LiangPI-boob/cell-metabolism-monitor/hardware/pcb/NanostatPictures.png

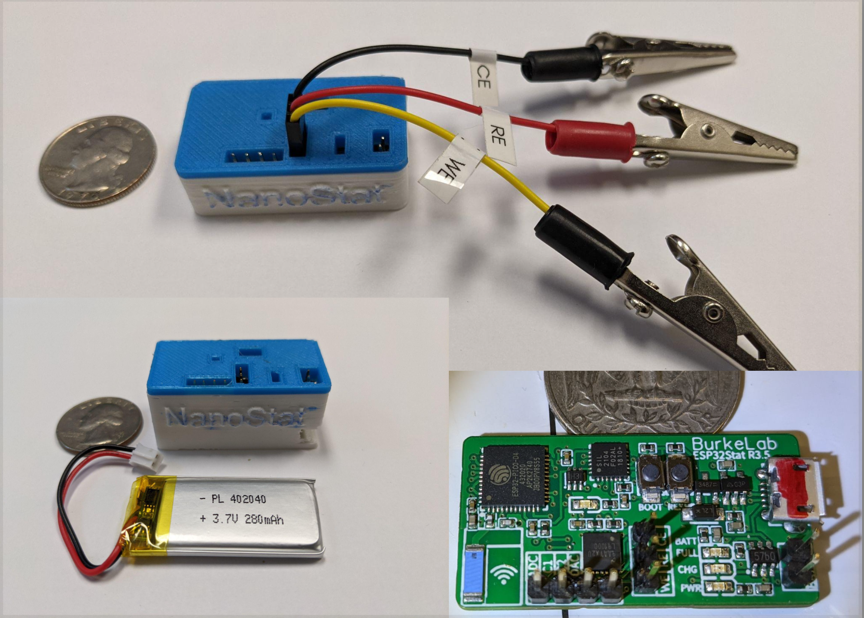
hardware/pcb/NanostatPictures.png
