LiangPI-boob/cell-metabolism-monitor/docs/协作者同步摘要.md

# 协作者同步摘要

> **用途**：让新协作者（及其 AI agent）用最短时间同步项目进度。
> **生成时间**：2026-10-27（已含第 4 轮「实时状态监控 + 泵 PWM 可调」改动）
> **建议阅读顺序**：本文件 → [`项目进度总结.md`](项目进度总结.md) → [`主从WiFi通信开发文档.md`](主从WiFi通信开发文档.md)

---

## 〇、仓库地址（重要）

| 项 | 值 |
|---|---|
| **当前协作仓库（GitHub）** | **https://github.com/LiangPI-boob/cell-metabolism-monitor**（公开） |
| 本地 remote 名 | `github`（另有一个历史 remote `origin` 指向 Gitee） |
| 协作者 | GitHub 用户 `shuhui-wang`（已发 write 权限邀请，需对方在 GitHub 接受） |

> ⚠️ **关于文档里出现的 Gitee 链接**
> `https://gitee.com/shuhui-wang/cell-metabolism-monitor` 是**协作者 shuhui-wang 此前使用的 Gitee 仓库地址**，仅作历史参考，**不是当前的同步目标**。
> 项目后续统一以 **GitHub 仓库 `LiangPI-boob/cell-metabolism-monitor`** 为准；若两处内容不一致，以 GitHub 为准。

---

## 一、给 AI agent 的同步指令（可直接复制）

> 请先读仓库根目录 `README.md`，**然后必须完整读 `docs/项目进度总结.md`**（跨会话上下文入口，含进度、代码位置行号、踩坑、卡点），再按需读 `docs/主从WiFi通信开发文档.md` 第 13 章。
> 当前状态：主机 ESP32 与从机 ESP32 已通过 Wi-Fi TCP 打通，实测 `"slave_link":"online"`。
> **唯一阻塞项是硬件电平问题——泵不转，因为 3.3V GPIO 驱动不了「5V 高电平触发」驱动模块，不要试图靠改代码解决。**
> 烧录前必须按 USB 序列号认板（`0001`=从机 COM5，`02DA3ECE`=主机 COM6）。改动前先 `git status`，凭据文件已 gitignore，不要提交。

---

## 二、项目是什么 + 系统架构

做一台**自动养细胞 + 自动测代谢指标（葡萄糖/乳酸）**的准连续监测系统：

1. 细胞在 PC 0.4μm 多孔膜上静置培养
2. 代谢物透过膜扩散进「膜下小体积腔」（约 78 μL）
3. 下腔与独立检测模块用软管闭环循环
4. 停流静测（安培法）+ 每 6 小时在线自校准
5. 覆盖 12~72 小时无人值守

```
[手机/PC 浏览器] ⇄ Wi-Fi ⇄ [主机 NanoStat：ESP32-PICO-D4 + LMP91000]
                              ├ 电化学采集（ADC/C1/C2/DAC）
                              ├ 网页 :80 + WebSocket :81
                              ├ 实验调度状态机（本机执行，不依赖 PC）
                              └ SoftAP「NanoStatAP」+ TCP Server 192.168.4.1:3333
                                        ⇅ JSON 行协议（Wi-Fi，一行一个 JSON，\n 结尾，≤512 B）
                                 [从机 ESP32 流体控制板]
                                  ├ 循环泵 → GPIO25
                                  ├ 切换阀 → GPIO26
                                  └ 排废阀 → GPIO27
```

实验状态机：`IDLE → CIRCULATE → STOP_FLOW → MEASURE →（CALIBRATE）→ CIRCULATE`

---

## 三、进度总览

| # | 阶段 | 状态 | 说明 |
|---|---|---|---|
| ① | 硬件采购 | ✅ 完成 | 全部到货 |
| ② | 开发环境 | ✅ 完成 | PlatformIO（主机）+ Arduino IDE（从机） |
| ③ | 从机固件 | ✅ 已烧录联网 | v1.2，COM5；`hello` 鉴权、心跳、断线重连实机通过 |
| ④ | 主机固件 | ✅ 已烧录最新 | COM6；APSTA + TCP Server + 调度状态机 + 链路广播 |
| ⑤ | 网页控制 | ✅ 已上传并可访问 | 4 页结构，uPlot 已本地化，无外网依赖 |
| ⑥ | 泵动作测试 | ⚠️ **根因已定位，未解决** | GPIO25 回 `ok:true` 但泵不转 → **3.3V 电平不足以触发 5V 高电平驱动模块** |
| ⑦ | 阀动作测试 | ⬜ 未做 | 两个阀均未实测动作 |
| ⑧ | 双板联调 | 🟡 链路已通 | 2026-10-25 实测 `slave_link:"online"`；T3–T8 台架测试待做 |
| ⑨ | 下腔替代件 | ⬜ 未做 | 图纸已画好（`hardware/drawings/`） |
| ⑩ | 流体管路图 | ✅ v1 完成 | `流体管路连接图_v1.svg`，含管段清单、装配顺序、3 个待确认项 |
| ⑪ | 代码共享 | ✅ 已推送 | GitHub 公开仓库（见本文第〇节） |

> **最近一次改动（2026-10-27）**：状态广播新增 `mode` / `next_action` / `next_in_ms` / `pump_pct`；停流拆为「开阀 `valve_open_s` + 关阀静置」两段；新增手动泵阀控制（会退出自动流程）；新增泵 PWM 占空比 `pump_pct`（默认 50%，1–100%）；网页新增下一动作倒计时、离线态、手动按钮与 PWM 滑块。详细清单与编译记录见 `项目进度总结.md` 4.8 节。同时已合并远端协作者提交（实验数据存档、掉线停机、浓度换算、演示模式，新增 `tools/analyze_experiment.py`）。

---

## 四、关键参数速查

| 项 | 值 |
|---|---|
| 认板方式 | 两块板都是 CP210x，**必须按序列号**：`0001` → COM5 = 从机；`02DA3ECE` → COM6 = 主机 |
| 主机板 | ESP32-PICO-D4 rev1.1，MAC `a4:f0:0f:1c:ee:34` |
| 从机板 | ESP32-D0WD-V3，MAC `ec:c9:ff:fe:c3:d0` |
| 主机引脚 | DAC 25、LED 26、LMP_C1 27、ADC 35、LMP_C2 39、MENB 5 |
| 从机引脚 | 循环泵 25、切换阀 26、排废阀 27（`GPIO1/3` 保留 USB 调试串口） |
| 板间链路 | 主机 SoftAP `NanoStatAP` + TCP Server `192.168.4.1:3333`；从机 STA 作 TCP Client |
| 心跳 | 主机每 5 s 发 `ping`；从机 120 s 无消息进安全态；主机 20 s 判离线 |
| 安全限时 | 阀最长 30 s、泵单次最长 1 h、上电默认泵停阀关 |
| 网页入口 | `http://192.168.4.1/`（连热点）或 `http://nanostat.local/`（路由模式） |
| 主机编译占用 | RAM 30.5%（100,012 B）、Flash 76.1%（997,229 B） |

---

## 五、首次上手 4 步

1. **补凭据**（不入库，缺失会 `#error`）：
   - `src/wifi_credentials.example.h` → `src/wifi_credentials.h`
   - `slave/slave_firmware/wifi_secrets.example.h` → `wifi_secrets.h`
   - `SLAVE_WIFI_PASS` 必须等于主机 `AP_PASSWORD`；`SLAVE_LINK_KEY` 两端必须一致
2. **烧主机**：

```powershell
$pio = "C:\Users\Liang\.platformio\penv\Scripts\pio.exe"
& $pio device list                                      # 先按 SN 确认 COM 口
& $pio run -e pico32 -t upload   --upload-port COM6
& $pio run -e pico32 -t uploadfs --upload-port COM6     # 仅在改了 data/ 网页时
```

3. **烧从机**：Arduino IDE 打开 `slave/slave_firmware/slave_firmware.ino`，装 ArduinoJson，选 COM5 上传
4. **验证链路（不动执行器）**：
   - `GET http://nanostat.local/netinfo` 看 `sta_connected` 与 `ap_clients`
   - 连 `ws://<主机IP>:81/` 读一帧状态，看 `"slave_link":"online"`

---

## 六、当前卡点与下一步

**卡点：泵不受 ESP32 控制（已定位为电平问题）**

| 测试 | 结果 | 结论 |
|---|---|---|
| 泵两根线直接接 5V | 泵转 | 电源、电源轨、泵正常 |
| 驱动模块 SIG 碰 5V | 泵转 | 驱动模块、接线正常 |
| GPIO25 → 模块 SIG，发 pump 命令 | 回 `ok:true`，泵不转 | **3.3V 不足以触发「5V 高电平触发」模块** |
| ESP32 GND ↔ 面包板蓝轨 | 已接 | 共地没问题 |

**下一步 6 步**

```
① 补 3.3V→5V 电平转换（BSS138 四路小板）或换 3.3V 兼容/带光耦模块 → 泵受控
     ↓
② 测两个阀（GPIO26/27，先 5V 碰听「咔哒」，再走命令）
     ↓
③ 台架 T3–T8：命令一致性 / 断线安全 / 换信道 / 24 h / EMI / 网页回归
     ↓
④ 管路干接 + 清水试漏（按《流体管路连接图_v1.svg》）
     ↓
⑤ 网页点「启动实验」，跑通 循环→停流→静测→校准（校准目前仍为占位，只计时）
     ↓
⑥ 做下腔替代件，替换烧杯接入回路
```

---

## 七、必知的坑（完整 11 条见 `项目进度总结.md` 第五节）

1. **串口日志停在 `BOOT: LMP init done` 不是崩溃** —— 是 CP210x 的 DTR/RTS 自动复位在反复拉 EN；判板子好坏看热点是否出现、LED 是否闪 15 次。
2. **`uploadfs` 会擦掉 SPIFFS 里的 `/calibration.JSON`** —— 日常不要跑；Wi-Fi 配置存在 NVS，不丢。
3. **国内网络装 ESP32 包 / PlatformIO 会卡** —— 用镜像或代理；移动工程后报错先删 `.pio`。
4. **不会误提交凭据** —— `.gitignore` 已覆盖 `src/wifi_credentials.h`、`slave/slave_firmware/wifi_secrets.h`、`data/secrets.json`、`.pio/`。

---

## 八、文件地图（按阅读优先级）

| 优先级 | 文件 | 用途 |
|---|---|---|
| 1 | `docs/项目进度总结.md` | **入口**：进度、代码行号位置、踩坑、卡点、下一步 |
| 2 | `docs/主从WiFi通信开发文档.md` | 协议、时序、改造点、13 章实机部署手册 |
| 3 | `README.md` | 目录结构、引脚、编译烧录、访问方式 |
| 4 | `docs/芯片设计说明书.md` / `docs/软件需求说明书.md` | 系统方案 / FR-1~FR-8 |
| 5 | `docs/硬件交接单.md` | 接线、共地、单件测试、安全约束 |
| — | `src/main.cpp`（主机 ~4200 行） | 固件主逻辑 |
| — | `slave/slave_firmware/slave_firmware.ino`（~350 行） | 从机固件 |
| — | `data/` | 网页（改完必须 `uploadfs`） |
| — | `.trae/specs/establish-master-gateway-wifi-link/` | 链路改造的 spec / tasks / checklist |

**主机固件关键函数位置（`src/main.cpp`）**

| 功能 | 约行号 |
|---|---|
| `setUpAPService()` | 1034 |
| `slaveSend()` / `slaveLoop()` | 4470 / 4486 |
| `expBroadcastState()` | 4640 |
| `expPumpRun()` | 4681 |
| `expStart()` | 4689 |
| `serviceExperiment()` | 4735 |

---

## 九、维护约定

- 进度变化时**优先更新 `docs/项目进度总结.md`**，再同步本文件第三节的表格与「生成时间」。
- 本文件只做「汇总与导航」，不重复设计文档的正文，避免两份内容打架。
- 仓库地址若有变更，请同步修改本文第〇节。

### 版本标记

每完成一轮需求（或一次可烧录验证的改动）在 `main` 上打一个附注标签，并在 GitHub 用该标签发布 Release：

```
git tag -a v0.4.0 -m "一句话说明本轮内容"
git push github v0.4.0
```

- 编号规则：`v0.<轮次>.0`，与 `项目进度总结.md` 的「第 N 轮需求」对齐；该轮内的修补用 `v0.4.1`。
- 标签只加不改：已推送的标签如需修正，用新的补丁号，不要强推覆盖。
- 固件要随版本分发时，`pio run -e pico32` 后把 `.pio/build/pico32/firmware.bin` 与 `spiffs.bin` 附到对应 Release，避免他人拿到与源码不一致的固件。
- 已有标签：`v0.4.0`（实时状态监控 + 泵 PWM + 协作者合并）。
