LiangPI-boob/cell-metabolism-monitor/docs/项目进度总结.md

# 细胞代谢监测系统 —— 项目进度总结

> **更新时间**：2026-10-27
> **用途**：跨对话传递上下文。**新对话 / 新 AI 会话请先读本文件**，再读配套文档。
> **配套文档**：《芯片设计说明书.md》《开发方案.md》《软件需求说明书.md》《硬件交接单.md》《主从WiFi通信开发文档.md》
> **工程根目录**：`f:\Trae\project\cell-metabolism-monitor`

---

## 一、项目是什么

**一句话**：做一台能**自动养细胞 + 自动测代谢指标（葡萄糖/乳酸）**的准连续监测系统。

**核心原理**
1. 细胞在多孔膜（PC 0.4μm）上静置培养
2. 代谢物透过膜扩散进「膜下小体积腔」（约 78 μL）
3. 下腔与独立检测模块用软管**闭环循环**
4. 停流静测（安培法）+ 每 6 小时**在线自校准**
5. 覆盖 **12~72 小时无人值守**

**系统架构（双 MCU）**

```
[手机/PC 浏览器] ⇄ Wi-Fi ⇄ [主机 NanoStat (ESP32-PICO-D4 + LMP91000)]
                              ├─ 电化学采集（ADC/C1/C2/DAC）
                              ├─ 网页 :80 + WebSocket :81
                              ├─ 实验调度状态机（本机执行，不依赖 PC）
                              └─ SoftAP「NanoStatAP」+ TCP Server :3333
                                        ⇅ JSON 行协议（Wi-Fi）
                                 [从机 ESP32 流体控制板]
                                  ├─ 循环泵 → GPIO25
                                  ├─ 切换阀 → GPIO26
                                  └─ 排废阀 → GPIO27
```

---

## 二、团队分工

| 人 | 负责 |
|---|---|
| **用户（本对话主人）** | **软件**：主机固件、从机固件、网页 |
| 同学 | 硬件：接线、机械加工、下腔替代件 |

---

## 三、整体进度总览

| 阶段 | 状态 | 说明 |
|---|---|---|
| ① 硬件采购 | ✅ 完成 | 全部到货 |
| ② 开发环境 | ✅ 完成 | Arduino IDE（从机）+ VS Code/PlatformIO（主机） |
| ③ 从机固件 | ✅ 已烧录并联网 | v1.2，COM5；`hello` 鉴权、心跳、断线重连全部实机通过 |
| ④ 主机固件 | ✅ 已烧录最新 | COM6；APSTA + TCP Server + 调度状态机 + 链路状态广播 |
| ⑤ 网页控制 | ✅ 已上传并可访问 | 4 页结构（控制台/参数/系统/帮助），uPlot 已本地化 |
| ⑥ 泵动作测试 | ⚠️ **根因已定位，未解决** | GPIO25 命令回 `ok:true` 但泵不转 → **3.3V 电平不足以触发 5V 高电平驱动模块** |
| ⑦ 阀动作测试 | ⬜ 未做 | 两个阀均未实测动作 |
| ⑧ 双板联调 | 🟡 **链路已通** | 2026-10-25 实测 `slave_link:"online"`；T3–T8 台架测试待做 |
| ⑨ 下腔替代件 | ⬜ 未做 | 图纸已画好（`hardware/drawings/`） |
| ⑩ 流体管路图 | ✅ v1 完成 | `流体管路连接图_v1.svg`，含管段清单、装配顺序、3 个待确认项 |
| ⑪ 代码共享 | ✅ 已推送 | **GitHub 公开仓库**（当前协作仓库）；Gitee 为协作者旧地址，见第八节 |

---

## 四、已完成工作的详细信息

### 4.1 硬件采购（全部到货）

| 物料 | 规格 | 数量 |
|---|---|---|
| 蠕动泵 + 驱动模块套件 | 5V，管 内径3mm×外径5mm | 2 |
| 单独驱动模块 | MOS 管型，**高电平触发**，支持 PWM | 2 |
| 电磁阀 | 0520E，**常闭(NC)**，额定 DC4.5V（工作 4.0~6.0V），320mA | 3 |
| 电源适配器 | 5V/2A | 1 |
| 锂电池 | 5V（备选供电） | 1 |
| 硅胶软管 | 内径3mm × 外径5mm | 5m |
| Y型三通 / L型弯头 | 3.2 / 3.0 | 各 10 |
| PC 膜 | 0.4 μm，90mm | 1 |
| 亚克力板 / 硅胶板 | 3mm / 1mm | 3 / 1 |
| O型圈 | 线径2.0 / 外径11mm | — |
| ESP32 开发板 | CP2102，Type-C（**从机**） | 1 |
| 面包板、杜邦线、拨插端子 | — | 若干 |

### 4.2 从机固件 ✅ 已烧录并联网

**文件**：`slave/slave_firmware/slave_firmware.ino`（v1.2，约 350 行）

**硬件配置**

| 执行器 | 引脚 | 通道号 |
|---|---|---|
| 循环泵 | GPIO25 | pump ch 0 |
| 切换阀 | GPIO26 | valve ch 0 |
| 排废阀 | GPIO27 | valve ch 1 |
| 接主机 | Wi-Fi STA → TCP Client `192.168.4.1:3333` | — |

**关键实现**
- **双通道**：USB Serial（调试）+ Wi-Fi TCP（接主机）；两个通道都能收命令，响应回到发命令的通道。`Serial2`（GPIO32/33）仅台架备用，**非运行链路**
- **驱动模块高电平触发**（已验证）：`HIGH` = 导通
- **安全保护**：心跳超时 **120 s** → 停泵关阀并上报（`g_safeLatched` 保证**只报一次**）；阀最长 **30 s**；泵单次最长 **1 h**；上电默认泵停阀关
- **断线重连**：退避 1 / 2 / 5 / 10 / 30 s；`WiFi.setSleep(false)`、`setAutoReconnect(true)`、`setNoDelay(true)`
- **半行缓冲修复**：TCP 刚断开会清空 `g_rxLineTcp`，避免重连后新旧半行拼接导致 `E_BAD_CMD`
- 非阻塞设计（全程 `millis()`）

**JSON 行协议（一行一个 JSON，`\n` 结尾，≤512 B）**

```json
{"cmd":"ping"}
{"id":1,"cmd":"pump","ch":0,"speed":50,"ms":60000}
{"id":2,"cmd":"valve","ch":0,"state":"open"}
{"id":3,"cmd":"stop_all"}
{"id":4,"cmd":"status"}
{"id":5,"cmd":"clear"}
```

响应 `{"id":1,"ok":true}` / `{"id":2,"ok":false,"err":"E_PARAM","msg":"..."}`；事件 `{"evt":"boot",...}`、`{"evt":"hb","state":"IDLE","uptime_ms":...}`、`{"evt":"fault","code":"E_NO_HEARTBEAT"}`、`{"evt":"hello","fw":"slave-1.2","key":"...","channels":{"pump":1,"valve":2}}`

**验证结果**：USB 串口正常输出 `boot` 与 5 s 一次 `hb`；已连上主机 AP 并通过 `hello` 鉴权，主机侧显示在线。

### 4.3 主机固件 ✅ 已烧录最新

**工程**：`platformio.ini` + `src/main.cpp`（约 4200 行，`[env:pico32]`）
**编译**：RAM 30.5%（100,012 B）、Flash 76.1%（997,229 B）（2026-10-27 合并远端后重新编译）

**板间链路模块（`src/main.cpp`）**

| 功能 | 位置 |
|---|---|
| `setUpAPService()`：`WIFI_AP_STA` + SoftAP `NanoStatAP` + `g_slaveServer.begin()` | 约 1034 |
| `slaveSend()` / `slaveLoop()`：接入、单客户端限制、按行解析、`hello` 鉴权、5 s `ping`、20 s 判离线 | 4470 / 4486 |
| `expBroadcastState()`：状态广播，含 `"slave_link":"online"/"offline"` | 4640 |
| `expPumpRun()`：泵 `ms = circulate_ms + 60000`（有限时长，不再常开） | 4681 |
| `expStart()`：从机离线时拒绝启动并广播 `{"exp_error":"slave_offline"}` | 4689 |
| `serviceExperiment()`：`IDLE → CIRCULATE → STOP_FLOW → MEASURE → (CALIBRATE) → CIRCULATE` | 4735 |
| `setup()`：启动顺序与 `BOOT:` 日志 | 约 4200 |

**关键行为**
- AP **常开**，STA 失败也不关 AP；STA 成功时 AP 跟随路由器信道
- 心跳在 IDLE 阶段也发（否则从机 120 s 后误判失联）
- 实验参数可在线改：`change_exp_circulate_min` / `stop_flow_min` / `calib_interval_h` / `calib_min`
- 校准阶段目前仍是**占位**（只计时，未接切阀/标准液）

**主机引脚**：`DAC=25`、`LED=26`、`LMP_C1=27`、`ADC=35`、`LMP_C2=39`、`MENB=5`
→ 与从机引脚重复是正常的，两块独立板。

### 4.4 网页 ✅ 已上传 SPIFFS

**目录**：`data/`

| 文件 | 作用 |
|---|---|
| `index.html` | 控制台：实验流程 / 手动扫描 / 实时曲线 |
| `setup.html` | 扫描参数（按模式折叠） |
| `system.html` | 系统：文件、Wi-Fi、固件、重启 |
| `help.html` | 帮助与关于（含「网络与访问方式」） |
| `assets/app.css` | 全站样式 |
| `assets/app.js` | 工具函数 + **全站唯一 WebSocket** + 网络提示条（读 `/netinfo`） |
| `assets/console.js` | 控制台逻辑 |
| `assets/system.js` | 系统页逻辑 |
| `assets/uplot.min.js/.css` | **本地图表库**，已不再引用外网 CDN |

**访问**：`http://nanostat.local/`（STA 已连路由器/热点时）或 `http://192.168.4.1/`（连 `NanoStatAP` 时）
**改网页后必须重新 `uploadfs`。**

### 4.5 板间链路实测结果（2026-10-25）

| 检查项 | 结果 |
|---|---|
| 主机 `/netinfo` | `{"ap_ssid":"NanoStatAP","ap_ip":"192.168.4.1","ap_clients":1,"sta_connected":true,"sta_ssid":"OnePlus Ace 5 Pro 5B70","sta_ip":"10.19.243.225","sta_rssi":-52}` |
| 主机 WebSocket 状态 | `{"exp_state":"IDLE","exp_cycle":0,"calib_in_ms":0,"pump_on":false,"valve0":false,"valve1":false,"circulate_min":5,"stopflow_min":5,"calib_interval_h":6,"calib_min":3,"slave_link":"online"}` |
| 从机串口 | `{"evt":"boot","fw":"slave-1.2",...}` + 5 s 一次 `{"evt":"hb","state":"IDLE",...}` |
| 结论 | **AP 接入、TCP 连接、`hello` 鉴权、心跳、状态广播全链路通过** |

### 4.6 项目文档

| 分类 | 文件 | 内容 |
|---|---|---|
| 方案 | `docs/芯片设计说明书.md` | 系统方案、芯片/检测模块参数、测量协议 |
| 方案 | `docs/开发方案.md` | 从机详细设计（硬件/固件/协议/测试/采购） |
| 方案 | `docs/软件需求说明书.md` | 软件需求，第四章＝对硬件的接口要求 |
| 方案 | `docs/实验创新性分析报告.md` | 系统级创新点论证 |
| 方案 | `docs/网页优化方案.md` | 网页结构、风格统一与格式规范 |
| 开发 | `docs/主从WiFi通信开发文档.md` | **主机↔从机 Wi-Fi TCP 链路：协议、改造点、测试计划、实施记录** |
| 硬件 | `docs/硬件交接单.md` | GPIO 分配、接线规范、单件测试、安全约束 |
| 硬件 | `hardware/drawings/` | 下腔替代件加工图、流体管路连接图、芯片设计图 |
| 进度 | `docs/项目进度总结.md` | 本文件 |
| 协作 | `docs/协作者同步摘要.md` | 给协作者及其 AI agent 的同步摘要（含仓库地址说明） |
| 汇报 | `docs/PPT大纲.md` | 汇报提纲 |
| 规格 | `.trae/specs/establish-master-gateway-wifi-link/` | `spec.md` / `tasks.md` / `checklist.md` |

### 4.7 开发环境与烧录

| 项 | 配置 |
|---|---|
| 工程根目录 | `f:\Trae\project\cell-metabolism-monitor` |
| PlatformIO | `C:\Users\Liang\.platformio`（`pio.exe` 在 `penv\Scripts\`） |
| 主机板 | ESP32-PICO-D4 rev1.1，MAC `a4:f0:0f:1c:ee:34`，CP210x **SN `02DA3ECE` → COM6** |
| 从机板 | ESP32-D0WD-V3，MAC `ec:c9:ff:fe:c3:d0`，CP210x **SN `0001` → COM5** |
| 从机编译 | 用**临时 PlatformIO 工程**（把 `.ino` 放进 `src/`，`board = esp32dev`，`ArduinoJson@^7`），或 Arduino IDE 选 ESP32 Dev Module |

**主机**

```powershell
$pio = "C:\Users\Liang\.platformio\penv\Scripts\pio.exe"
& $pio device list                    # 先确认 COM 口（按 SN 区分两块板）
& $pio run -e pico32 -t upload  --upload-port COM6
& $pio run -e pico32 -t uploadfs --upload-port COM6
```

**从机**：Arduino IDE 打开 `slave/slave_firmware/slave_firmware.ino` → 选 COM5 → 上传。

**凭据（均不入库，`.gitignore` 已覆盖）**

| 文件 | 内容 | 备注 |
|---|---|---|
| `src/wifi_credentials.h` | `SSID`/`PASSWORD`（占位）、`AP_PASSWORD`、`SLAVE_LINK_KEY` | `SSID/PASSWORD` 目前**不参与连接**，路由器凭据由网页保存 |
| `slave/slave_firmware/wifi_secrets.h` | `SLAVE_WIFI_SSID`=NanoStatAP、`SLAVE_WIFI_PASS`=**必须等于** `AP_PASSWORD`、`SLAVE_LINK_KEY`=**必须与主机一致** | 缺失时编译直接 `#error` |

> Wi-Fi STA 凭据实际保存在 **NVS**（`connectAttempt("","")` 读 NVS），所以 `uploadfs` 不会丢 Wi-Fi 配置；
> 但 `/calibration.JSON` 在 **SPIFFS** 里，`uploadfs` 会擦掉，重烧前如需保留请先备份。

---

### 4.8 2026-10-27 改动（第 4 轮需求：实时状态监控 + 泵 PWM 可调）

**代码改动**：4 个文件，+395 / −22（`src/main.cpp`、`data/index.html`、`data/assets/console.js`、`data/assets/app.css`）

**主机固件 `src/main.cpp`**

- 状态广播新增 `mode`（auto / manual / idle）、`next_action`、`next_in_ms`、`pump_pct`：告知前端下次要启动哪个泵或阀、还剩多久、当前模式
- **停流阶段拆成两个子阶段**：先开阀 `valve_open_s`（默认 10 s，可调 1–30 s），再关阀静置；倒计时按子阶段计算
- 新增 `g_expMeasuring`：静测采集前先广播 `measuring`，避免倒计时停在 `00:00` 让人误以为卡死
- `expPumpRun()` 补上 `g_slavePumpOn = true`，修复静测结束后重启泵时页面状态不刷新
- IDLE 空闲态也保持每 5 s 一次 `status` 轮询（其余状态 1 s），泵/阀状态不再滞留旧值
- 新增手动命令 `manual_pump` / `manual_valve0` / `manual_valve1`：任一动作先 `stop_all` 并退出自动流程，必须重新点「启动实验」才恢复
- 新增参数命令 `change_exp_circulate_min` / `change_exp_stopflow_min` / `change_exp_valve_s` / `change_exp_calib_interval_h` / `change_exp_calib_min`
- **泵 PWM**：新增 `exp_param_pump_pct`（默认 50%，范围 1–100%）与 `change_exp_pump_pct`；自动循环、校准、手动开泵统一使用；运行中调整按当前阶段剩余时长重发 `pump` 命令，立即生效且不改变剩余运行时间

**网页 `data/`**

- 「下一动作」行：动作名 + 剩余时间，前端每 250 ms 本地走秒，1 s 广播纠正
- 泵、切换阀、排废阀三行支持离线态（虚线红框 + 「离线」）；从机断开时倒计时改显示「从机离线」
- 手动按钮 6 个，按目标状态互斥禁用，离线全禁用
- 「实验参数」卡新增阀门开启时长输入（1–30 s），其余周期参数与固件值双向同步
- 「实验流程」卡新增 PWM 滑块 + 百分比读数；`pendingPct` 机制避免旧广播把滑块回弹

**编译与烧录（2026-10-27）**

| 设备 | 端口 | 结果 |
|---|---|---|
| 主机 | COM6 | 文件系统 1,441,792 B + 固件 997,616 B，Hash 校验通过；RAM 30.5% / Flash 75.6% |
| 从机 | COM5 | 固件 751,856 B，Hash 校验通过；RAM 13.7% / Flash 56.9% |

- 从机用 `%TEMP%\pio_slave` 临时 PlatformIO 工程编译（复用本机 ArduinoJson 7.4.3），**未改动仓库中的从机源码**
- 从机首次以 460800 波特率烧录在 30% 处中断，降到 115200 后成功
- 主机启动日志正常：AP+STA 双模、`[SLAVE] client connected from 192.168.4.2`

**待办（网页实测）**：倒计时平滑性、手动退出自动、离线三路同显、阀门时长生效、PWM 滑块实时生效

**同步远端**：远端已有协作者提交 `58e0804`（实验数据存档、掉线停机、浓度换算、演示模式 + `tools/analyze_experiment.py`）。已合并，冲突仅 `src/main.cpp` 5 处，按「两侧功能并存」解决：参数命令并存；`expStart` 兼顾会话初始化与手动/停流/静测复位；`expStop` 保留故障复位与 STOP 日志；`serviceExperiment` 中 IDLE 仍每 5 s 轮询 `status`，故障/掉线判定只在非 IDLE 生效；静测完成保留 measuring 复位与浓度换算/记录。合并后重新编译通过（RAM 30.5% / Flash 76.1%），**尚未重新烧录与实测**。

---

## 五、踩过的坑 & 解决方案（**重要，别重复踩**）

| # | 现象 | 原因 | 解决 |
|---|---|---|---|
| 1 | 串口日志反复停在 `BOOT: LMP init done`、看着像启动崩溃/重启循环 | **CP210x 自动复位电路（DTR=GPIO0，RTS=EN）**：每次打开串口都会拉低 EN 复位；监控工具反复开关端口就会刷出一串 `rst:0x1 (POWERON_RESET)` | 这是**假象**。一次打开端口、持续监听即可看到完整启动日志；判板子好坏请看热点是否出现、LED 是否闪 15 次 |
| 2 | `netsh wlan show networks` 看不到 `NanoStatAP` | 无线网卡当前连着别的 SSID 时，扫描结果不全/滞后 | 用手机看热点，或先把电脑切到别的网络再扫；**不能据此判定 AP 没起来** |
| 3 | `uploadfs` 后校准系数丢失 | SPIFFS 被整块擦除（`0x290000`，1.44 MB） | 重烧前先 `GET /calibration.JSON` 备份，放进 `data/` 一起烧上去，烧完再删本地副本 |
| 4 | 从机编译报 `#error 缺少 wifi_secrets.h` | 凭据文件不入库，clone/清理后会缺 | 从 `.example.h` 复制并填真实值；`SLAVE_WIFI_PASS` = 主机 `AP_PASSWORD`，`SLAVE_LINK_KEY` 两端一致 |
| 5 | 两块板都是 CP210x，容易烧错 | 同型号、端口号会变 | **按序列号区分**：`0001`=从机、`02DA3ECE`=主机；烧前先 `pio device list` |
| 6 | 主机插上电脑但设备管理器没有 CP210x | 线只供电不传数据 / 口不通 / 接头没插到位 | 换数据线、换机箱后面板 USB 口；插上应有系统提示音 |
| 7 | 网页图表空白 | 早期版本引用 `cdn.plot.ly`，热点模式无外网 | 已改为**本地 uPlot**；若仍空白，检查是否漏了 `uploadfs` |
| 8 | 从机心跳超时后串口刷屏 `E_NO_HEARTBEAT` | 原逻辑每圈 `loop()` 都触发一次 | 已用 `g_safeLatched` 修复：一次超时只报一次，收到新命令后解锁 |
| 9 | ESP32 开发板包装不上，GitHub 超时 | 国内访问 GitHub | Arduino IDE 加 jihulab 镜像，且选带 `-cn` 的版本 |
| 10 | PlatformIO 卡 `Downloading 0%` | 同上 | 用手机热点或开代理；或把 `platform` 指向本地 `~/.platformio/platforms/espressif32`，跳过在线安装 |
| 11 | 移动/改名工程后编译报错 | `.pio` 缓存记录旧路径 | 删 `.pio` 重新编译 |

---

## 六、当前卡点：泵不受 ESP32 控制（已定位为电平问题）

| 测试 | 结果 | 结论 |
|---|---|---|
| 泵两根线直接接 5V | 泵转 | 电源、面包板电源轨、泵正常 |
| 驱动模块 SIG 用杜邦线碰 5V | 泵转 | 驱动模块、接线正常 |
| ESP32 GPIO25 → 模块 SIG，发 pump 命令 | 串口回 `ok:true`，泵不转 | **3.3V 输出不足以触发「5V 高电平触发」模块** |
| ESP32 GND ↔ 面包板蓝轨 | 已接 | 共地没问题 |

**结论**：软件/协议没问题，问题在 **3.3V → 5V 电平**。
**解决**：买 3.3V→5V 电平转换模块（BSS138 四路小板）或换 3.3V 兼容/带光耦的驱动模块。

---

## 七、下一步计划

```
① 补 3.3V→5V 电平转换 → 泵受控（GPIO25）
     ↓
② 测两个阀（GPIO26/27，5V 碰听「咔哒」，再走命令）
     ↓
③ 台架 T3–T8：命令一致性 / 断线安全 / 换信道 / 24 h / EMI / 网页回归
     ↓
④ 管路干接 + 清水试漏（按《流体管路连接图_v1.svg》）
     ↓
⑤ 网页点「启动实验」，跑通 循环→停流→静测→校准
     ↓
⑥ 做下腔替代件，替换烧杯接入回路
```

---

## 八、文件路径速查

| 内容 | 路径 |
|---|---|
| 工程根目录 | `f:\Trae\project\cell-metabolism-monitor` |
| 主机固件 | `src/main.cpp` |
| 主机凭据 | `src/wifi_credentials.h`（不入库） |
| 网页文件 | `data/`（改完要 `uploadfs`） |
| 从机固件 | `slave/slave_firmware/slave_firmware.ino` |
| 从机凭据 | `slave/slave_firmware/wifi_secrets.h`（不入库） |
| 设计文档 | `docs/` |
| 规格/任务/清单 | `.trae/specs/establish-master-gateway-wifi-link/` |
| 硬件资产 | `hardware/pcb`、`hardware/case`、`hardware/drawings` |
| PlatformIO 核心 | `C:\Users\Liang\.platformio` |
| **GitHub 仓库（当前协作仓库）** | **`https://github.com/LiangPI-boob/cell-metabolism-monitor`**（公开，remote 名 `github`） |
| Gitee 仓库（协作者旧地址，仅历史参考） | `https://gitee.com/shuhui-wang/cell-metabolism-monitor`（remote 名 `origin`，非当前同步目标） |
| 版本标签 | `v0.4.0`（第 4 轮：实时状态监控 + 泵 PWM + 协作者合并）；约定见 `docs/协作者同步摘要.md` 第九节 |

---

## 九、给下一个对话 / 下一个 AI 会话的提示

1. **先读本文件，再读 `docs/主从WiFi通信开发文档.md`**，后者有完整协议、时序参数和各改造点代码位置。
2. 用户是软件负责人，**编程基础不深**：解释要通俗，给「点哪里 / 敲什么命令」的级别，避免堆术语。
3. **两块独立的 ESP32 板**，引脚重复正常；板间链路走 Wi-Fi，**不占任何 GPIO**（UART 方案因主机 PCB 无排针已废弃）。
4. **烧录前必须按序列号认板**：COM5=`0001`=从机，COM6=`02DA3ECE`=主机。端口号会变，序列号不会。
5. **不要把"串口日志停在 LMP init"当成崩溃**：那是 CP210x 自动复位在反复拉 EN。判定板子是否正常，看热点 `NanoStatAP` 是否出现、LED 是否闪 15 次。
6. 验证链路最快的办法（不改代码、不动执行器）：
   - `GET http://nanostat.local/netinfo` 看 `sta_connected` 与 `ap_clients`
   - 连 `ws://<主机IP>:81/` 读一帧状态，看 `"slave_link":"online"`
7. **不要用 `uploadfs` 当日常操作**：会擦掉 SPIFFS 里的 `/calibration.JSON`；只改网页时才需要。
8. 当前最紧急的硬件问题是 **3.3V→5V 电平**，不是软件；不要试图用改代码解决泵不转。
9. 改动前先确认 `git status`，凭据文件（`wifi_credentials.h`、`wifi_secrets.h`）已加入 `.gitignore`，**不要提交**。
