LiangPI-boob/cell-metabolism-monitor/hardware/pcb/Version3dot5dot0/BOM_1-PCB_ESP32StatRev3_5PCB_2022-08-24.csv

ID | Name | Designator | Footprint | Quantity | Manufacturer Part | Manufacturer | Supplier | Supplier Part | Price | Pins | 3DModel
1 | LMP91000SD/NOPB | U4 | WSON-14_L4.0-W4.0-P0.50-BL-EP | 1 |  |  |  |  |  | 15
2 | U254-051T-4BH23-S2B | USB1 | MINI-USB-SMD_U254-051T-4BH23-S2B | 1 |  |  |  |  |  | 9
3 | RST | RESET | SW-SMD_L3.9-W3.0-P4.45 | 1 |  |  |  |  |  | 2
4 | 22K | R11 | R0402 | 1 |  |  |  |  |  | 2
5 | 47K | R13 | R0402 | 1 |  |  |  |  |  | 2
6 | TP4057 | U7 | SOT-23-6_L2.9-W1.6-P0.95-LS2.8-BR | 1 |  |  |  |  |  | 6
7 | 2.15K | R7,R9 | R0402 | 2 |  |  |  |  |  | 2
8 | 1K | R1 | R0402 | 1 |  |  |  |  |  | 2
9 | TS-1088R-02026 | BOOT | SW-SMD_L3.9-W3.0-P4.45 | 1 |  |  |  |  |  | 2
10 | 19-213/Y2C-CQ2R2L/3T(CY) | CHG | LED0603-R-RD | 1 |  |  |  |  |  | 2
11 | 10K | R2,R3,R4,R12 | R0402 | 4 |  |  |  |  |  | 2
12 | CP2104-F03-GM | U3 | QFN-24_L4.0-W4.0-P0.50-BL-EP2.8 | 1 |  |  |  |  |  | 25
13 | 330 | R8,R5 | R0402 | 2 |  |  |  |  |  | 2
14 | 19-217/GHC-YR1S2/3T | FULL | LED0603-R-RD | 1 |  |  |  |  |  | 2
15 | 19-217/BHC-ZL1M2RY/3T | LED2 | LED0603-R-RD | 1 |  |  |  |  |  | 2
16 | 10uF | C1,C2,C11,C3,C12 | C0402 | 5 |  |  |  |  |  | 2
17 | HDR-M-2.54_1x2 | VBAT/GND | HDR-M-2.54_1X2 | 1 |  |  |  |  |  | 2
18 | PWR | PWR | LED0603-R-RD | 1 |  |  |  |  |  | 2
19 | MBR120LSF | D5 | SOD-123_L2.8-W1.8-LS3.7-RD | 1 |  |  |  |  |  | 2
20 | UMH3NTN | Q3 | SOT-363_L2.0-W1.3-P0.65-LS2.1-TL | 1 |  |  |  |  |  | 6
21 | AP2112K-3.3TRG1 | U6 | SOT-25-5_L3.0-W1.8-P0.95-LS3.0-BR | 1 |  |  |  |  |  | 5
22 | 100nF | C4,C6,C7,C9 | C0402 | 4 |  |  |  |  |  | 2
23 | HDR-M-2.54_1x3 | WE/RE/CE | HDR-M-2.54_1X3 | 1 |  |  |  |  |  | 3
24 | 1.2pF | C10 | C0402 | 1 |  |  |  |  |  | 2
25 | 5.1nH | L2 | L0402 | 1 |  |  |  |  |  | 2
26 | KH-5220-A56 | L1 | ANT-SMD_L5.2-W2.0 | 1 |  |  |  |  |  | 2
27 | ESP32-PICO-D4 | U1 | QFN-48_L7.0-W7.0-P0.50-TL-EP5.1 | 1 |  |  |  |  |  | 49
28 | HDR-M-2.54_1x4 | J3 | HDR-M-2.54_1X4 | 1 |  |  |  |  |  | 4
29 | 100nF | C5 | C0402 | 1 |  |  |  |  |  | 2 | C0402_L1.0-W0.5-H0.5
30 | LPSC3487 | Q4 | SOT-23_L2.9-W1.3-P0.95-LS2.4-BR | 1 |  |  |  |  |  | 3
