LiangPI-boob/cell-metabolism-monitor/hardware/pcb/Version3dot5dot4/BOM_ESP32StatRev3_5_4_2024-11-27.csv

ID | Name | Designator | Footprint | Quantity | Manufacturer Part | Manufacturer | Supplier | Supplier Part | Price
1 | Header-Male-2.54_1x3 | WE/RE/CE | HDR-TH_3P-P2.54-V-M-1 | 1 | 2.54-1*3P针 | BOOMELE(博穆精密) | LCSC | C49257 | 0.014
2 | 1.5pF | C10 | C0402 | 1 | GRM1555C1H1R5BA01D | muRata(村田) | LCSC | C76957 | 0.004
3 | KPT-1608ZGC | BLNK,CHARGE,FULL,PWR | LED0603-RD_GREEN | 4 | KPT-1608ZGC | Kingbright | LCSC | C598364 | 0.293
4 | PZ254V-11-02P | VBAT/GND | HDR-TH_2P-P2.54-V-M | 1 | PZ254V-11-02P | XFCN(兴飞) | LCSC | C492401 | 0.012
5 | SI2333 | Q5 | SOT-23_L2.9-W1.3-P1.90-LS2.4-BR | 1 | SI2333 | BORN(伯恩半导体) | LCSC | C344008 | 0.05
6 | KH5220-A36 | L4 | ANT-SMD_L5.2-W2.1 | 1 | KH5220-A36 | kinghelm(金航标) | LCSC | C484543 | 0.199
7 | 4.3nH | L5 | L0402 | 1 | SDCL1005C4N3STDF | Sunlord(顺络) | LCSC | C52051 | 0.003
8 | TP4057 | U7 | SOT-23-6_L2.9-W1.6-P0.95-LS2.8-BR | 1 | TP4057 | TOPPOWER | LCSC | C12044 | 0.122
9 | RT9078-33GJ5 | U5 | TSOT-23-5_L2.9-W1.6-P0.95-LS2.8-BR | 1 | RT9078-33GJ5 | Richtek Tech | LCSC | C110427 | 0.079
10 | UMH3NTN | Q3 | SOT-363_L2.0-W1.3-P0.65-LS2.1-TL | 1 | UMH3NTN | ROHM | LCSC | C123008 | 0.055
11 | U254-051T-4BH83-F1B | USB2 | MINI-USB-SMD_U254-051T-4BH83-F1B | 1 | U254-051T-4BH83-F1B | XKB Enterprise | LCSC | C319162 | 0.064
12 | CP2104-F03-GM | U3 | QFN-24_L4.0-W4.0-P0.50-BL-EP2.7 | 1 | CP2104-F03-GM | SILICON LABS | LCSC | C47742 | 2.105
13 | LMP91000SD/NOPB | U4 | WSON-14_L4.0-W4.0-P0.50-BL-EP | 1 | LMP91000SD/NOPB | TI | LCSC | C84366 | 3.22
14 | RST | RESET | SW-SMD_L3.9-W3.0-P4.45 | 1 | TS-1088R-02026 | XUNPU | LCSC | C455280 | 0.044
15 | 22K | R11 | R0402 | 1 | 0402WGF2202TCE | UniOhm | LCSC | C25768 | 0.001
16 | 47K | R13 | R0402 | 1 | 0402WGF4702TCE | UniOhm | LCSC | C25792 | 0.001
17 | 2.15K | R7 | R0402 | 1 | 0402WGF2151TCE | UniOhm | LCSC | C25878
18 | 1K | R1 | R0402 | 1 | 0402WGF1001TCE | UniOhm | LCSC | C11702 | 0.001
19 | TS-1088R-02026 | BOOT | SW-SMD_L3.9-W3.0-P4.45 | 1 | TS-1088R-02026 | XUNPU | LCSC | C455280 | 0.044
20 | 10K | R2,R3,R4,R12 | R0402 | 4 | 0402WGF1002TCE | UniOhm | LCSC | C25744 | 0.001
21 | 330 | R8,R5 | R0402 | 2 | 0402WGF3300TCE | UniOhm | LCSC | C25104 | 0.001
22 | 10uF | C1,C2,C11,C3,C12 | C0402 | 5 | CL05A106MQ5NUNC | SAMSUNG | LCSC | C15525 | 0.004
23 | MBR120LSF | D5 | SOD-123_L2.8-W1.8-LS3.7-RD | 1 | MBR120LSF | SK | LCSC | C130880 | 0.035
24 | 100nF | C4,C5,C6,C7,C9 | C0402 | 5 | CL05B104KO5NNNC | SAMSUNG | LCSC | C1525 | 0.001
25 | ESP32-PICO-D4 | U1 | QFN-48_L7.0-W7.0-P0.50-TL-EP5.1 | 1 | ESP32-PICO-D4 | Espressif Systems | LCSC | C193707 | 4.72
26 | HDR-M-2.54_1x4 | J3 | HDR-M-2.54_1X4 | 1 |  |  | LCSC | C124378 | 0.037
