LiangPI-boob/cell-metabolism-monitor/hardware/case/nobattery/Lid.stl

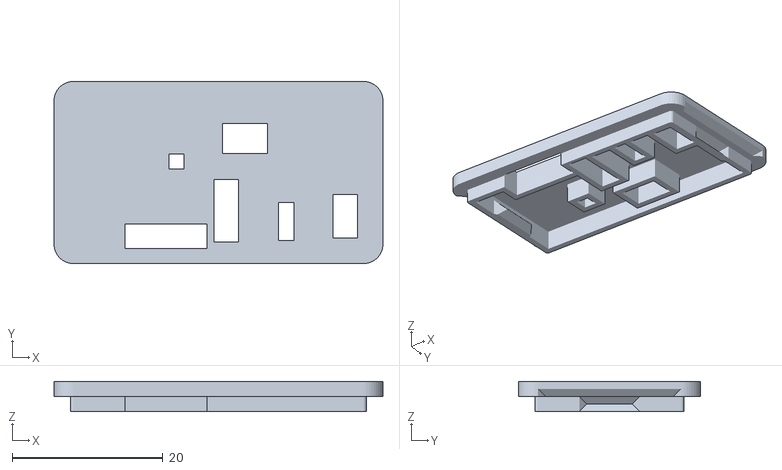
[picture p7: CAD file, 2026-10-18]
hardware/case/nobattery/Lid.stl
43.7 x 24.2 x 4.00
