LiangPI-boob/cell-metabolism-monitor/hardware/case/withbattery/Lid.stl

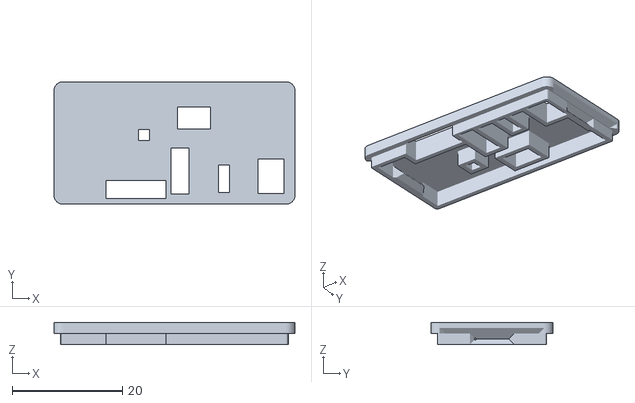
[picture p8: CAD file, 2026-10-18]
hardware/case/withbattery/Lid.stl
43.7 x 22.2 x 4.00
