LiangPI-boob/cell-metabolism-monitor/hardware/case/nobattery/Case.stl

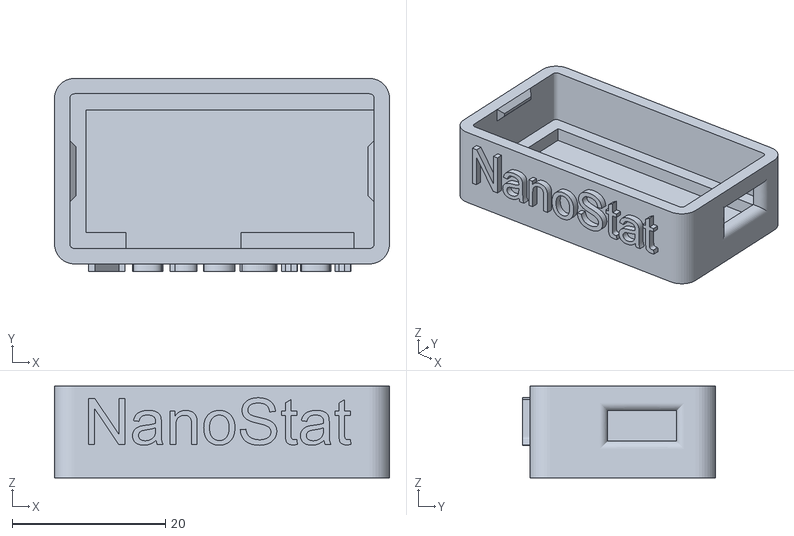
[picture p9: CAD file, 2026-10-18]
hardware/case/nobattery/Case.stl
43.7 x 25.2 x 12.0
