LiangPI-boob/cell-metabolism-monitor/hardware/case/withbattery/Case.stl

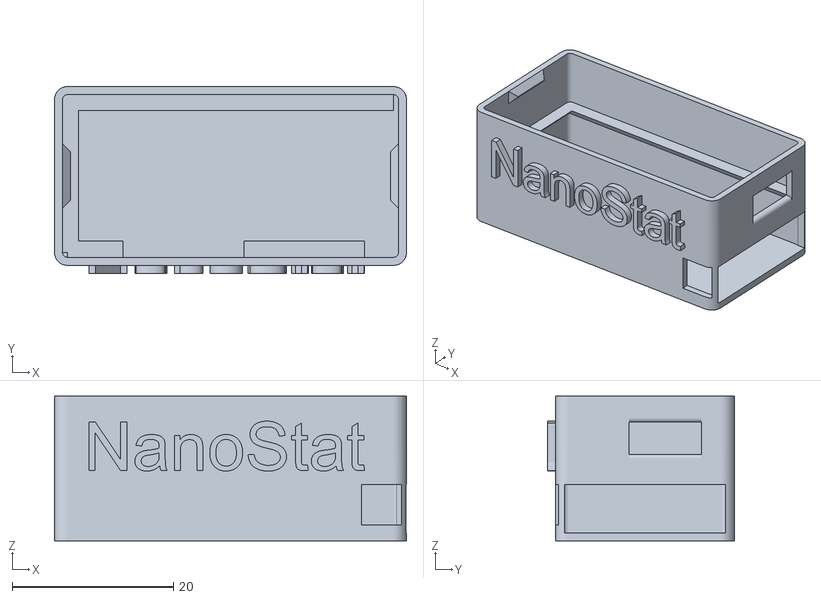
[picture p10: CAD file, 2026-10-18]
hardware/case/withbattery/Case.stl
43.7 x 23.2 x 18.0
