LiangPI-boob/cell-metabolism-monitor/(list of files, cad)

Other CAD files:
hardware/case/nobattery/NanoStatCaseNoLipoFinal v2.f3d
hardware/case/withbattery/NanoStatCaseWithLipo v147.f3d
