LiangPI-boob/cell-metabolism-monitor/hardware/pcb/Version3dot5dot0/Gerber_1-PCB_ESP32StatRev3_5PCB/How-to-order-PCB.txt

How to Order PCB

Please refer to:
https://docs.easyeda.com/en/PCB/Order-PCB
