LiangPI-boob/cell-metabolism-monitor/(list of files, drawings)

Other design files:
hardware/pcb/Version3dot5dot4/PCB_1-PCB_ESP32StatRev3_5_4_2024-11-27.json
hardware/pcb/Version3dot5dot4/SCH_ESP32StatRev3_5_4_2024-11-27.json
