LiangPI-boob/cell-metabolism-monitor/src/main.cpp

//https://github.com/PeterJBurke/Nanostat

bool userpause = false;             // pauses for user to press input on serial between each point in sweep
bool print_output_to_serial = true; // prints verbose output to serial

//Libraries
#include <Wire.h>
#include <WiFi.h>
#include "Arduino.h"
#include <ESPAsyncWebServer.h>
#include <ESPmDNS.h>
#include <SPIFFS.h>
#include <time.h>
#include <AsyncJson.h>
// 凭据来自不入库的 wifi_credentials.h（由 wifi_credentials.example.h 复制）。
#if __has_include("wifi_credentials.h")
#include "wifi_credentials.h"
#else
#error "缺少 wifi_credentials.h：请复制 src/wifi_credentials.example.h 为 src/wifi_credentials.h 并填写"
#endif

#ifndef AP_PASSWORD
#error "缺少 AP_PASSWORD：请在 src/wifi_credentials.h 中定义（至少 8 位）"
#endif
#ifndef SLAVE_LINK_KEY
#error "缺少 SLAVE_LINK_KEY：请在 src/wifi_credentials.h 中定义（须与从机 wifi_secrets.h 一致）"
#endif

#include "LMP91000.h"
#include "WebSocketsServer.h"
#include "DNSServer.h"
// #include <OTA.h>
#include <Update.h>
#include "soc/soc.h"
#include "soc/rtc_cntl_reg.h"



// Microcontroller specific info (pinouts, Vcc, etc)
const uint16_t opVolt = 3300;                 //3300 mV
const uint8_t adcBits = 12;                   // ESP32 ADC is 12 bits
const uint16_t dacResolution = pow(2, 8) - 1; // ESP32 DAC is 8 bits, that is 12.9 mV for 3300 mV reference...
//LMP91000 control pins
const uint8_t dac = 25; // DAC pin for Vref to drive LMP91000. Pin 25 on BurkeLab ESP32Stat Rev 3.5
const uint8_t MENB = 5; // LMP91000 enable pin. Hard wired to ground in BurkeLab ESP32Stat Rev 3.5
//analog input pins to read voltages
const uint8_t LMP_C1 = 27; // Note C1, C2 not wired to microcontroller in BurkeLab ESP32Stat Rev 3.5
const uint8_t LMP_C2 = 39; // Note C1, C2 not wired in microcontroller in BurkeLab ESP32Stat Rev 3.5
const uint8_t LMP = 35;    // ADC pin for Vout reading. Pin 35 on BurkeLab ESP32Stat Rev 3.5
// calibration of ESP32 ADC (see calibration routine)
float a_coeff = -146.63; // hard code coeffs but they can be updated with calibration routine
float b_coeff = 7.64;    // hard code coeffs but they can be updated with calibration routine
// For BurkeLab ESP32Stat Rev 3.5, LED "blinky" pin.
int LEDPIN = 26;

// ============================================================
//  新增：从机（流体控制板）通信 + 实验调度
//  主机 <-> 从机：Wi-Fi / TCP，主机 AP 侧 192.168.4.1:3333
//  （从机作为 TCP Client 主动连接，应用层仍是单行 JSON 协议）
// ============================================================

// 从机链路 TCP Server（AP 常开，STA 可选）
WiFiServer g_slaveServer(3333);
WiFiClient g_slaveClient;

void slaveLoop();          // 收从机的响应 / 事件
void serviceExperiment();  // 实验调度状态机
void expStart();           // 启动实验
void expStop();            // 停止实验
void expManual(uint8_t target, bool on); // 手动控制泵/阀（0=泵 1=切换阀 2=排废阀）
void expBroadcastState();  // 向网页广播实验/链路状态
void expPumpPctApply();    // 泵运行中应用新的 PWM 占空比

// 多源数据同步（统一时钟 + 通用数据行）
void timeSyncTick();       // NTP 对时（非阻塞）
uint64_t nowEpochMs();     // 绝对时间（ms），未对时返回 0
void expLogExt(const char *source, const char *type, double value,
               const char *unit, const char *note);
void expLogTimeSync();     // 记录 boot→epoch 映射，供离线对齐

// 实验参数（定义在文件后部的调度模块）
extern uint32_t exp_param_circulate_ms;
extern uint32_t exp_param_valve_open_ms;
extern uint32_t exp_param_stopflow_ms;
extern uint32_t exp_param_calib_interval_ms;
extern uint32_t exp_param_calib_ms;
extern uint32_t exp_param_pump_pct;

// 浓度换算标定（临时骨架：I = slope * C + intercept）
float g_concSlope     = 0.0f;  // µA / mM
float g_concIntercept = 0.0f;  // µA
void loadConcCalib();
void saveConcCalib();

// Global mode control (sweep type)
enum Sweep_Mode_Type
{
  dormant,  // not sweeping
  NPV,      // normal pulsed voltametry
  DPV,      // differential pulsed voltametry
  CV,       // cyclic voltametry
  SQV,      // square wave voltametry
  CA,       // chronoamperometry
  IV,       // IV curve
  CAL,      // calibrate
  DCBIAS,   // DC bias at a fixed point
  CTLPANEL, // Control panel type interface
  MISC_MODE // miscellanous
};
Sweep_Mode_Type Sweep_Mode = dormant;

// Sweep parameters (to be set by user through HTML form posts but defaults on initialization)
// (Initialized to their default values)
// General sweep parameters:
int sweep_param_lmpGain = 7;       //  (index) gain setting for LMP91000
bool sweep_param_setToZero = true; //   Boolean

// CV sweep parameters:
// runCV(sweep_param_lmpGain, sweep_param_cycles_CV, sweep_param_startV_CV,
// sweep_param_endV_CV, sweep_param_vertex1_CV, sweep_param_vertex2_CV, sweep_param_stepV_CV,
// sweep_param_rate_CV, sweep_param_setToZero);
int sweep_param_cycles_CV = 3;     //  (#)  number of times to run the scan
int sweep_param_startV_CV = 0;     //   (mV)  voltage to start the scan
int sweep_param_endV_CV = 0;       //     (mV)  voltage to stop the scan
int sweep_param_vertex1_CV = 100;  //  (mV)  edge of the scan
int sweep_param_vertex2_CV = -100; // (mV)  edge of the scan
int sweep_param_stepV_CV = 5;      // (mV)      how much to increment the voltage by
int sweep_param_rate_CV = 100;     // (mV/sec)       scanning rate

// NPV sweep parameters:
// runNPV(sweep_param_lmpGain, sweep_param_startV_NPV, sweep_param_endV_NPV,
//            sweep_param_pulseAmp_NPV, sweep_param_pulseAmp_NPV, sweep_param_period_NPV,
//            sweep_param_quietTime_NPV, uint8_t range, sweep_param_setToZero)
int sweep_param_startV_NPV = -200; //   (mV)  voltage to start the scan
int sweep_param_endV_NPV = 200;    //     (mV)  voltage to stop the scan
int sweep_param_pulseAmp_NPV = 20;
int sweep_param_width_NPV = 50;
int sweep_param_period_NPV = 200;
int sweep_param_quietTime_NPV = 1000;

// DPV sweep parameters:
// runDPV(sweep_param_lmpGain, sweep_param_startV_DPV, sweep_param_endV_DPV,
//            sweep_param_pulseAmp_DPV, sweep_param_pulseStep_DPV, sweep_param_period_DPV,
//            sweep_param_quietTime_DPV, uint8_t range, sweep_param_setToZero)
int sweep_param_startV_DPV = -200; //   (mV)  voltage to start the scan
int sweep_param_endV_DPV = 200;    //     (mV)  voltage to stop the scan
int sweep_param_pulseAmp_DPV = 20;
int sweep_param_pulseStep_DPV = 5; // (mV)      how much to increment the voltage by  
int sweep_param_width_DPV = 50;
int sweep_param_period_DPV = 200;
int sweep_param_quietTime_DPV = 1000;

// SWV sweep parameters:
// runSWV(sweep_param_lmpGain, sweep_param_startV_SWV, sweep_param_endV_SWV,
//            sweep_param_pulseAmp_SWV, sweep_param_stepV_SWV, sweep_param_freq_SWV, sweep_param_setToZero)
int sweep_param_startV_SWV = -200; //   (mV)  voltage to start the scan
int sweep_param_endV_SWV = 200;    //     (mV)  voltage to stop the scan
int sweep_param_pulseAmp_SWV = 20;
int sweep_param_stepV_SWV = 5; // (mV)      how much to increment the voltage by
int sweep_param_freq_SWV = 10;

// CA sweep parameters:
// runAmp(sweep_param_lmpGain, sweep_param_pre_stepV_CA, sweep_param_quietTime_CA,
//            sweep_param_V1_CA, sweep_param_t1_CA, sweep_param_V2_CA, sweep_param_t2_CA,
//            sweep_param_samples_CA, uint8_t range, sweep_param_setToZero)
int sweep_param_pre_stepV_CA = 50;
int sweep_param_quietTime_CA = 2000;
int sweep_param_V1_CA = 100;
int sweep_param_t1_CA = 2000;
int sweep_param_V2_CA = 50;
int sweep_param_t2_CA = 2000;
int sweep_param_samples_CA = 100;

// Noise test sweep parameters:
// testNoiseAtABiasPoint(sweep_param_biasV_noisetest, sweep_param_numPoints_noisetest,
//                           sweep_param_delayTime_ms_noisetest)
int sweep_param_biasV_noisetest = -100;
int sweep_param_numPoints_noisetest = 100;
int sweep_param_delayTime_ms_noisetest = 50;

// IV sweep parameters:
// testIV(sweep_param_startV_IV, sweep_param_endV_IV, sweep_param_numPoints_IV,
//            sweep_param_delayTime_ms_IV)
int sweep_param_startV_IV = -200; //   (mV)  voltage to start the scan
int sweep_param_endV_IV = 200;    //     (mV)  voltage to stop the scan
int sweep_param_numPoints_IV = 701;
int sweep_param_delayTime_ms_IV = 50;

// Cal sweep parameters:
// calibrateDACandADCs(sweep_param_delayTime_ms_CAL)
int sweep_param_delayTime_ms_CAL = 50;

// Arrays of IV curves etc:
const uint16_t arr_samples = 5000; //use 1000 for EIS, can use 2500 for other experiments (10k does not fit in DRAM)
uint16_t arr_cur_index = 0;
int16_t volts[arr_samples] = {0}; // single sweep IV curve "V"
float amps[arr_samples] = {0};    // single sweep IV curve "I"
int32_t time_Voltammaogram[arr_samples] = {0};
int number_of_valid_points_in_volts_amps_array = 0; // rest of them are all zeros...

// runAmp 的三个阶段（pre-step / v1 / v2）在数组中的起止下标，
// 供实验调度取“稳定段”电流用（批次 0=pre-step, 1=v1, 2=v2）
uint16_t g_ampPhaseStart[3] = {0, 0, 0};
uint16_t g_ampPhaseEnd[3]   = {0, 0, 0};

// JSON string to sent over websockets to browswer client:
// char Voltammogram_JSON_cstr[31000];
// char Voltammogram_JSON_cstr[31000];
//char Voltammogram_JSON_cstr2[31000];
int16_t volts_temp = 0;
float amps_temp = 0;
float v1_temp = 0;
float v2_temp = 0;
float analog_read_avg_bits_temp = 0;
String temp_json_string = "";

const float v_tolerance = 0.008;     //0.0075 works every other technique with 1mV step except CV which needs minimum 2mV step
unsigned long lastTime = 0;          // global variable, last time xyz was called in  ms....
uint16_t dacVout = 1500;             // desired output of the DAC in mV
float adc_avg = 0;                   // used in noise test subroutine, better to make it local eventually...
float adc_std_dev = 0;               // used in noise test subroutine, better to make it local eventually...
int num_adc_readings_to_average = 1; // when reading ADC, how many points to average....

// LMP91000 global status settings:
// Parameters the user can set on LMP91000:
// TIA gain (keep max at 350k feedback resistor)
// Rload (keep at 10 ohms)
// Ref source int/ext (keep ext)
// Int_Z zero 50 20 67% (keep at 50%)
// Bias_Sign (plus/minus)
// Bias 1%-24%
// FET_Short (keep off)
// Mode (keep at 3-lead)
uint8_t LMPgainGLOBAL = 7; // Feedback resistor of TIA.
//void LMP91000::setGain(uint8_t gain) const
//@param            gain: the gain to be set to
//param - value - gain resistor
//0 - 000 - External resistor
//1 - 001 - 2.75 kOhm
//2 - 010 - 3.5 kOhm
//3 - 011 - 7 kOhm
//4 - 100 - 14 kOhm
//5 - 101 - 35 kOhm
//6 - 110 - 120 kOhm
//7 - 111 - 350 kOhm
uint8_t bias_setting = 0; // determines percentage of VREF applied to CE opamp, from 1% to 24%
// from LMP91000.h:
//const double TIA_BIAS[] = {0, 0.01, 0.02, 0.04, 0.06, 0.08, 0.1, 0.12, 0.14,
//    0.16, 0.18, 0.2, 0.22, 0.24};
float RFB = 1e6; // feedback resistor if using external feedback resistor

// create pStat object to control LMP91000
LMP91000 pStat = LMP91000();

// create webserver object for website:
AsyncWebServer server(80); //

// Websockets:
// Tutorial: https://www.youtube.com/watch?v=ZbX-l1Dl4N4&list=PL4sSjlE6rMIlvrllrtOVSBW8WhhMC_oI-&index=8
// Tutorial: https://www.youtube.com/watch?v=mkXsmCgvy0k
// Code tutorial: https://shawnhymel.com/1882/how-to-create-a-web-server-with-websockets-using-an-esp32-in-arduino/
// Github: https://github.com/Links2004/arduinoWebSockets
WebSocketsServer m_websocketserver = WebSocketsServer(81);
String m_websocketserver_text_to_send = "";
String m_websocketserver_text_to_send_2 = "";
int m_time_sent_websocketserver_text = millis();
int m_microsbefore_websocketsendcalled = micros();
int last_time_loop_called = millis();
int last_time_sent_websocket_server = millis();
float m_websocket_send_rate = 1.0; // Hz, how often to send a test point to websocket...
bool m_send_websocket_test_data_in_loop = false;

//WifiTool object
int WAIT_FOR_WIFI_TIME_OUT = 6000;
const char *PARAM_MESSAGE = "message"; // message server receives from client
std::unique_ptr<DNSServer> dnsServer;
std::unique_ptr<AsyncWebServer> m_wifitools_server;
const byte DNS_PORT = 53;
bool restartSystem = false;

// Control panel mode settings: (Control panel mode is browser page like a front panel of instrument)
uint8_t LMPgain_control_panel = 6; // Feedback resistor of TIA.
int num_adc_readings_to_average_control_panel = 1;
int sweep_param_delayTime_ms_control_panel = 50;
int cell_voltage_control_panel = 100;

//******************* END VARIABLE DECLARATIONS**************************8

boolean connectAttempt(String ssid, String password)
{
  boolean isWiFiConnected = false;
  // set mode
  WiFi.mode(WIFI_STA);
  // if no SSID is passed we attempt last connected wifi (from WIFI object)
  if (ssid == "")
  {
    if (WiFi.status() != WL_CONNECTED)
    {
      WiFi.begin();
    }
  }
  else
  {
    int ssidSize = ssid.length() + 1;
    int passwordSize = password.length() + 1;
    char ssidArray[ssidSize];
    char passwordArray[passwordSize];
    ssid.toCharArray(ssidArray, ssidSize);
    password.toCharArray(passwordArray, passwordSize);
    WiFi.begin(ssidArray, passwordArray);
  } //end if

  if (ssid == "")
  {
    Serial.print(F("Connecting Wifi default SSID ..."));
  }
  else if (ssid != "")
  {
    Serial.print(F("Connecting Wifi SSID = "));
    Serial.print(ssid);
    Serial.print(F(" ..."));
  }
  unsigned long now = millis();
  while (WiFi.status() != WL_CONNECTED && millis() < now + WAIT_FOR_WIFI_TIME_OUT)
  {
    Serial.print(".");
    delay(250);
  }
  // Serial.print(F("\nStatus:"));
  // Serial.println(WiFi.status());
  if (WiFi.status() == WL_CONNECTED)
  {
    Serial.println(F("\nWiFi connected"));
    Serial.println(F("IP address: "));
    Serial.println(WiFi.localIP());
    Serial.print(F("ssid: "));
    Serial.println(WiFi.SSID());
    //Serial.print(F("password: "));
    //Serial.println(WiFi.psk());
    isWiFiConnected = true;
  }

  return isWiFiConnected;
}

void sendTimeOverWebsocketJSON() // sends current time as JSON object to websocket
{
  String json = "{\"value\":";
  json += String(millis() / 1e3, 3);
  json += "}";
  m_websocketserver.broadcastTXT(json.c_str(), json.length());
}

void sendValueOverWebsocketJSON(int value_to_send_over_websocket) // sends integer as JSON object to websocket
{
  String json = "{\"value\":";
  json += String(value_to_send_over_websocket);
  json += "}";
  m_websocketserver.broadcastTXT(json.c_str(), json.length());
}

void sendStringOverWebsocket(String string_to_send_over_websocket)
{
  m_websocketserver.broadcastTXT(string_to_send_over_websocket.c_str(), string_to_send_over_websocket.length());
}

void send_is_sweeping_status_over_websocket(bool is_sweeping)
{
  if (is_sweeping)
  {
    // send is sweeping
    temp_json_string = "{\"is_sweeping\":true}";
  };
  if (!is_sweeping)
  {
    // send is not sweeping
    temp_json_string = "{\"is_sweeping\":false}";
  };
  m_websocketserver.broadcastTXT(temp_json_string.c_str(), temp_json_string.length());
}

void send_expect_binary_data_over_websocket(bool expect_binary_data)
{
  if (expect_binary_data)
  {
    // send is sweeping
    temp_json_string = "{\"expect_binary_data\":true}";
  };
  if (!expect_binary_data)
  {
    // send is not sweeping
    temp_json_string = "{\"expect_binary_data\":false}";
  };
  m_websocketserver.broadcastTXT(temp_json_string.c_str(), temp_json_string.length());
}

void sendVoltammogramWebsocketJSON()
{
  // old version used String, had memory probs for large arrays
  // psuedo code:
  // 1) Convert voltammagram to JSON...
  // Voltammagram JSON format will be like this:
  // { "Current" : [3,2,6,...], "Voltage": [8,6,7,....], "Time": [3,4,5,...]}
  // 2) Send JSON over websocket...

  Serial.println("sendVoltammogramWebsocketJSON called");
  Serial.print("number_of_valid_points_in_volts_amps_array=");
  Serial.println(number_of_valid_points_in_volts_amps_array);

  String current_array_string = "[";
  String voltage_array_string = "[";
  String time_array_string = "[";
  for (uint16_t i = 0; i < number_of_valid_points_in_volts_amps_array; i++)
  {

    current_array_string += amps[i];
    if (i != (number_of_valid_points_in_volts_amps_array - 1))
    {
      current_array_string += ",";
    }

    voltage_array_string += volts[i];
    if (i != (number_of_valid_points_in_volts_amps_array - 1))
    {
      voltage_array_string += ",";
    }

    time_array_string += (time_Voltammaogram[i] - time_Voltammaogram[0]); // normalize to start of sweep time
    if (i != (number_of_valid_points_in_volts_amps_array - 1))
    {
      time_array_string += ",";
    }
  }
  current_array_string += "]";
  voltage_array_string += "]";
  time_array_string += "]";

  String Voltammogram_JSON = "";
  Voltammogram_JSON += "{\"Current\":";
  Voltammogram_JSON += current_array_string;
  Voltammogram_JSON += ",\"Voltage\":";
  Voltammogram_JSON += voltage_array_string;
  Voltammogram_JSON += ",\"Time\":";
  Voltammogram_JSON += time_array_string;
  Voltammogram_JSON += "}";

  if (print_output_to_serial)
  {
    Serial.println("####################################");
    Serial.println("Just created Voltammogram_JSON string.");
    Serial.println("Ingredients of string:");
    Serial.println("current_array_string:");
    Serial.println(current_array_string);
    Serial.println("voltage_array_string:");
    Serial.println(voltage_array_string);
    Serial.println("time_array_string:");
    Serial.println(time_array_string);

    Serial.println("####################################");
    Serial.println("Beginning sending Voltammogram_JSON over websocket.");
    if (print_output_to_serial)
    {
      Serial.println(Voltammogram_JSON);
    }
    Serial.print("Heap free memory (in bytes)= ");
    Serial.println(ESP.getFreeHeap());
  }

  m_websocketserver.broadcastTXT(Voltammogram_JSON.c_str(), Voltammogram_JSON.length());

  if (print_output_to_serial)
  {
    Serial.println("Finished sending Voltammogram_JSON over websocket.");
    Serial.println("####################################");
  }
}

void sendVoltammogramWebsocketBIN()
{
  // send data over websocket binary
  // psuedo code:
  // 1) Convert voltammagram to JSON...
  // Voltammagram JSON format will be like this:
  // { "Current" : [3,2,6,...], "Voltage": [8,6,7,....], "Time": [3,4,5,...]}
  // 2) Send JSON over websocket...
  // Version 2 tries to use char[] instead of String for memory management (String can't hold all the data)

  // Refernce arrays we are going to use to write:
  // Arrays of IV curves etc:
  // const uint16_t arr_samples = 5000; //use 1000 for EIS, can use 2500 for other experiments (10k does not fit in DRAM)
  // uint16_t arr_cur_index = 0;
  // int16_t volts[arr_samples] = {0}; // single sweep IV curve "V"
  // float amps[arr_samples] = {0};    // single sweep IV curve "I"
  // int32_t time_Voltammaogram[arr_samples] = {0};
  // int number_of_valid_points_in_volts_amps_array = 0; // rest of them are all zeros...

  Serial.println("sendVoltammogramWebsocketBIN called");
  Serial.print("Heap free memory (in bytes)= ");
  Serial.println(ESP.getFreeHeap());
  Serial.println("Creating binary array to send to browswer");
  Serial.print("number_of_valid_points_in_volts_amps_array=");
  Serial.println(number_of_valid_points_in_volts_amps_array);

  // reset time to zero for 1st point: (unless it's already been done!)
  if (time_Voltammaogram[0] != 0)
  {
    int32_t temp_time, temp_start_time;
    temp_start_time = time_Voltammaogram[0];
    for (uint16_t i = 0; i < number_of_valid_points_in_volts_amps_array; i++)
    {
      temp_time = time_Voltammaogram[i];
      time_Voltammaogram[i] = temp_time - temp_start_time;
    }
  }

  bool m_headerToPayload = false;

  //  *********BEGIN Websocket sample code for sending binary array of floats*****************
  // int m_num_in_test_array = 10;
  // float m_test_float_array[m_num_in_test_array];
  // for (uint8_t i = 0; i < m_num_in_test_array; i += 1)
  // {
  //   m_test_float_array[i] = 3.1415 + i;
  //   Serial.print("m_test_float_array[i]=");
  //   Serial.println(m_test_float_array[i]);
  // }
  // size_t m_test_float_array_buffer_len = m_num_in_test_array * sizeof(float); // 4 byte
  // Serial.print("m_test_float_array_buffer_len=");
  // Serial.println(m_test_float_array_buffer_len);
  // m_websocketserver.broadcastBIN((uint8_t *)m_test_float_array, m_test_float_array_buffer_len, m_headerToPayload);
  //  *********END Websocket sample code for sending binary array of floats*****************

  //  *********BEGIN Websocket  code for sending  arrays*****************
  int m_amps_array_buffer_len = sizeof(float) * number_of_valid_points_in_volts_amps_array;
  int m_volts_array_buffer_len = sizeof(int16_t) * number_of_valid_points_in_volts_amps_array;
  int m_time_array_buffer_len = sizeof(int32_t) * number_of_valid_points_in_volts_amps_array;
  Serial.print("m_amps_array_buffer_len=");
  Serial.println(m_amps_array_buffer_len);
  Serial.print("m_volts_array_buffer_len=");
  Serial.println(m_volts_array_buffer_len);
  Serial.print("m_time_array_buffer_len=");
  Serial.println(m_time_array_buffer_len);

  // Tell browswer to get ready for 3 new binary array messages:
  send_expect_binary_data_over_websocket(true);
  // Arrays are aleady in memory, no need to use more memory, just send them directly:
  m_websocketserver.broadcastBIN((uint8_t *)amps, m_amps_array_buffer_len, m_headerToPayload);
  m_websocketserver.broadcastBIN((uint8_t *)volts, m_volts_array_buffer_len, m_headerToPayload);
  m_websocketserver.broadcastBIN((uint8_t *)time_Voltammaogram, m_time_array_buffer_len, m_headerToPayload);

  //  *********END Websocket  code for sending  arrays*****************

  if (print_output_to_serial)
  {
    Serial.println("Finished sending sendVoltammogramWebsocketBIN over websocket.");
    Serial.println("####################################");
  }
}

void blinkLED(int pin, int blinkFrequency_Hz, int duration_ms)
// blinks LED for duration ms using frequency of blinkFrequency
{
  int delayPeriod_ms = (1e3) / (2 * blinkFrequency_Hz);
  int t = 0;
  while (t < duration_ms)
  {
    digitalWrite(pin, HIGH);
    delay(delayPeriod_ms);
    digitalWrite(pin, LOW);
    delay(delayPeriod_ms);
    t += 2 * delayPeriod_ms;
  }
}

void pulseLED_on_off(int pin, int on_duration_ms)
// blinks LED on for on_duration_ms
{
  digitalWrite(pin, HIGH);
  delay(on_duration_ms);
  digitalWrite(pin, LOW);
}

inline void setLMPBias(int16_t voltage)
{
  //Sets the LMP91000's bias to positive or negative
  signed char sign = (float)voltage / abs(voltage);
  if (sign < 0)
    pStat.setNegBias();
  else if (sign > 0)
    pStat.setPosBias();
}

void setOutputsToZero()
{
  //Sets the electrochemical cell to 0V bias.
  dacWrite(dac, 0); // ESP32
  pStat.setBias(0);
}

void initLMP(uint8_t lmpGain)
{
  //Initializes the LMP91000 to the appropriate settings
  //for operating MiniStat.
  pStat.disableFET();      // Don't short WE and RE.
  pStat.setGain(lmpGain);  // Set feedback resistor of LMP gain.
  pStat.setRLoad(0);       // Low resistance (10 ohms) between WE and TIA input.
  pStat.setExtRefSource(); // Cell voltage determined by external pin.
  pStat.setIntZ(1);        // TIA uses internal resistor for gain setting.
  pStat.setThreeLead();    // 3 lead potentiostat configuration.
  pStat.setBias(0);        // Zero voltage on cell, DAC.
  pStat.setPosBias();      // Positive bias.
  setOutputsToZero();      // Zero voltage on cell, DAC.
}

inline uint16_t convertDACVoutToDACVal(uint16_t dacVout)
{
  //dacVout       voltage output to set the DAC to
  //
  //Determines the correct value to write to the digital-to-analog
  //converter (DAC) given the desired voltage, the resolution of the DAC

  // dacResolution=2^8-1 ESP32 = 255
  // opVolt =3300 mV
  // DACVal integer 0 to 255 scaled to dacVout/opVolt
  // so resolution is 13 mV!!!

  return dacVout * ((float)dacResolution / opVolt);
}

inline float analog_read_avg(int num_points, int pin_num)
{
  // Reads adc at pin_num for num_points and returns average.
  float analogRead_result = 0;

  for (int16_t j = 0; j < num_points; j += 1)
  {
    analogRead_result += analogRead(pin_num);
  }

  return analogRead_result / num_points;
}

inline void setVoltage(int16_t voltage)
{
  // Sets the DAC voltage, LMP91000 bias percentage, and LMP91000 bias sign, to get the desired cell voltage.
  // "voltage" is the desired cell voltage (RE minus WE)
  // Assumes DAC is perfect.

  // This function iterates bias_setting, dacVout until it finds a solution within v_tolerance of voltage (the desired cell voltage)
  // End result is bias_setting (integer), dacVout (in mV) which goes to LMP91000 and ESP32
  // setV (the cell voltage the user will actually get)
  // is given by dacVout * TIA_BIAS[bias_setting]
  // TIA_BIAS[bias_setting] varies from 1% to 22% depending on setting; note initially set to 0%...

  // global variables used in this function:
  // v_tolerance: how close to desired cell voltage user can tolerate since it is digitized
  // dacVout: desired output of the DAC in mV
  // bias_setting: determines percentage of VREF applied to CE opamp, from 1% to 24%

  const uint16_t minDACVoltage = 1520; // Minimum DAC voltage that can be set;
                                       //the LMP91000 accepts a minium value of 1.5V, adding the
  //additional 20 mV for the sake of a bit of a buffer

  dacVout = minDACVoltage; // global variable, initialized to a convenient value in this method, will be changed in iteration
  bias_setting = 0;        // global variable, initialized to a convenient value in this method, will be changed in iteration

  //if (abs(voltage) < 15)
  //{
  // voltage = 15 * (voltage / abs(voltage));
  //voltage cannot be set to less than 15mV because the LMP91000
  //accepts a minium of 1.5V at its VREF pin and has 1% as its
  //lowest bias option 1.5V*1% = 15mV
  //}

  int16_t setV = dacVout * TIA_BIAS[bias_setting]; // "setV" is the exact cell voltage we will get, try to get it close to "voltage"
  voltage = abs(voltage);                          // (sign handled elsewhere in the code...)

  if (abs(voltage) < 15)
  {
    // make executive decision
    if (abs(voltage) > 7.5)
    {
      //    make it 15 mV
      voltage = 15 * (voltage / abs(voltage));
    }
    else if (abs(voltage) <= 7.5)
    {
      // make it zero
      bias_setting = 0;
      setV = 0;
      dacVout = 1500;
    }
  }

  if (abs(voltage) >= 15)
  {
    // iterate
    while (setV > voltage * (1 + v_tolerance) || setV < voltage * (1 - v_tolerance)) // iterate to find
    // bias_setting (integer), dacVout (in mV) which goes to LMP91000 and ESP32
    // so that setV = dacVout * TIA_BIAS[bias_setting] is within v_tolerance of voltage (desired by user)
    {
      if (bias_setting == 0)
        bias_setting = 1;

      dacVout = voltage / TIA_BIAS[bias_setting];

      if (dacVout > opVolt)
      {
        bias_setting++;
        dacVout = 1500;

        if (bias_setting > NUM_TIA_BIAS)
          bias_setting = 0;
      }

      setV = dacVout * TIA_BIAS[bias_setting];
    }
  }
  pStat.setBias(bias_setting); // sets percentage voltage divider in LMP910000
  // dacwrite is ESP32 version of analogWrite
  dacWrite(dac, convertDACVoutToDACVal(dacVout)); // sets ESP32 DAC bits
}

inline float biasAndSample(int16_t voltage, uint32_t rate)
{
  //Sets the bias of the electrochemical cell then samples the resulting current.
  //@param        voltage: Set the bias of the electrochemical cell
  //@param        rate:    How much to time (in ms) should we wait to sample
  //                       current after biasing the cell. This parameter
  //                       sets the scan rate or the excitation frequency
  //                       based on which electrochemical technique
  //                       we're running.

  // Global variables assumed:
  // lastTime: last time in system ms this function was called (for timing reference)
  // num_adc_readings_to_average: self explanatory
  // float a = a_coeff; float b = b_coeff; // global calibration coefficients for ADC to voltage correction

  // Global variables used in this function implicit through setVoltage:
  // v_tolerance: how close to desired cell voltage user can tolerate since it is digitized
  // dacVout: desired output of the DAC in mV
  // bias_setting: determines percentage of VREF applied to CE opamp, from 1% to 24%

  setLMPBias(voltage); // Sets the LMP91000's bias to positive or negative // voltage is cell voltage
  setVoltage(voltage); // Sets the DAC voltage, LMP91000 bias percentage, and LMP91000 bias sign, to get the desired cell "voltage".

  if (rate > 10) // we can afford the time to pulse the LED for 10 ms, just waiting anyways
  {
    pulseLED_on_off(LEDPIN, 10); // signify start of a new data point
  }
  else if (rate < 10) // we cannot afford the time to pulse the LED for 10 ms, so pulse 1 ms only
  {
    pulseLED_on_off(LEDPIN, 1); // signify start of a new data point
  }

  //delay sampling to set scan rate
  while (millis() - lastTime < rate) // wait then sample
    ;

  // Read output voltage of the transimpedance amplifier
  int adc_bits; // will be output voltage of TIA amplifier, "VOUT" on LMP91000 diagram, also C2
  // hard wired in BurkeLab ESP32Stat Rev 3.5 to LMP i.e ESP32 pin 32 (ADC1_CH7)
  adc_bits = analog_read_avg(num_adc_readings_to_average, LMP); // read a number of points and average them...

  // Now convert adc_bits to actual voltage on Vout.
  // Without calibration, we would assume that virtual ground (WE = C1) is 50% of Vref.
  // Without calibration, we would assume that C2-C1=I_WE * RTIA, and C2 is VOUT is ADC reading.
  // However, C1 is not 50% of Vref.
  // Calibration takes care of this by reading C2 as a function of ADC set voltage (assuming perfect ADC) and then
  // correcting C2 using Vout_calibrated = (adcbits/4095)*3.3V corrected by slope/offset measured during calibration, as follows:
  // First, user opens WE so no current flows, then runs the cal function, which sets LMP cell voltage to Zero and varies Vref i.e. Vdac.
  // That function measures Vadc as a function of Vdac and fits this formula (defining a,b):
  // adc(bits) = a + b * dac = a + b * dacvoltage * (255/3.3); here dac voltage is assumed correct
  // Correction from ADC to Vout then given by (in volts):
  // v1 = (3.3 / 255.0) * (1 / (2.0 * b)) * (float)adc_bits - (a / (2.0 * b)) * (3.3 / 255.0);

  //  Calibrate coefficients (make a local copy of the global ones):
  float a = a_coeff; // a is local copy of global a_coeff
  float b = b_coeff; // b is local copy of global a_coeff

  float v1;
  v1 = (3.3 / 255.0) * (1 / (2.0 * b)) * (float)adc_bits - (a / (2.0 * b)) * (3.3 / 255.0); // LMP is wired to Vout of the LMP91000
  v1 = v1 * 1000;

  float v2 = dacVout * .5; //the zero of the internal transimpedance amplifier
  // V2 is not measured in  BurkeLab ESP32Stat Rev 3.5 and assumed to be half dacVout, calibration helps this see above
  float current = 0;

  //the current is determined by the zero of the transimpedance amplifier
  //from the output of the transimpedance amplifier, then dividing
  //by the feedback resistor
  //current = (V_OUT - V_IN-) / RFB
  //v1 and v2 are in milliVolts
  if (LMPgainGLOBAL == 0)                              // using external feedback resistor, hard coded to 1e6 for now with BurkeLab ESP32Stat Rev 3.5
    current = (((v1 - v2) / 1000) / RFB) * pow(10, 9); //scales to nA
  else
    current = (((v1 - v2) / 1000) / TIA_GAIN[LMPgainGLOBAL - 1]) * pow(10, 6); //scales to uA

  if (print_output_to_serial)
  {
    // Serial.print("******** BIAS AND SAMPLE START********************)");
    Serial.print(int(millis())); // current time in ms
    // Serial.print(F(","));        // comma
    Serial.print(F("\t")); // tab
    Serial.print(voltage); // desired cell voltage
    // Serial.print(F(","));  // comma
    Serial.print(F("\t"));                          // tab
    Serial.print(dacVout * TIA_BIAS[bias_setting]); // SET cell voltage
    // setV = dacVout * TIA_BIAS[bias_setting]
    // Serial.print(F(",")); // comma
    Serial.print(F("\t"));                   // tab
    Serial.print(TIA_BIAS[bias_setting], 2); // scale divider
    // Serial.print(F(","));                    // comma
    Serial.print(F("\t"));      // tab
    Serial.print(dacVout, DEC); // dacVout a global variable, calculated in setVoltage(voltage);
    // Serial.print(F(","));       // comma
    Serial.print(F("\t"));     // tab
    Serial.print(adc_bits, 0); // adc_bits
    // Serial.print(F(","));      // comma
    Serial.print(F("\t")); // tab
    Serial.print(v1, 1);   // Vout
    // Serial.print(F(",")); // comma
    Serial.print(F("\t")); // tab
    Serial.print(v2, 0);   // C1, should be the zero also....
    // Serial.print(F(",")); // comma
    Serial.print(F("\t")); // tab
    Serial.print(current, 4);
    // Serial.print(F(",")); // comma
    Serial.print(F("\t")); // tab
    // Serial.print("******** BIAS AND SAMPLE END********************)");
  }

  //update timestamp for the next measurement
  lastTime = millis();
  return current;
}

void writeVoltsCurrentArraytoFile()
{
  File file = SPIFFS.open("/data.txt", FILE_WRITE);

  if (!file)
  {
    Serial.println("There was an error opening the file for writing");
    return;
  }
  if (file.println("BurkeLab Nanostat Rev 3.5 Sweep"))
  {
    Serial.println("Header of file was written");
  }
  else
  {
    Serial.println("File write failed");
  }
  Serial.println("Writing file.");
  Serial.println("number_of_valid_points_in_volts_amps_array=");
  Serial.println(number_of_valid_points_in_volts_amps_array);

  file.print("Index");
  file.print(F("\t")); // tab
  file.print("Current_Amps");
  file.print(F("\t")); // tab
  file.print("Voltage_V");
  file.print(F("\t")); // tab
  file.println("Time_ms");

  //Wrie Arrays
  for (uint16_t i = 0; i < number_of_valid_points_in_volts_amps_array; i++)
  {
    file.print(i);
    file.print(F("\t")); // tab
    file.print(amps[i], DEC);
    file.print(F("\t")); // tab
    file.print(volts[i] / 1e3, DEC);
    file.print(F("\t"));                                         // tab
    file.println(time_Voltammaogram[i] - time_Voltammaogram[0]); // normalize to start of sweep
  }
  file.close();
}

void readFileAndPrintToSerial()
{
  File file2 = SPIFFS.open("/data.txt");

  if (!file2)
  {
    Serial.println("Failed to open file for reading");
    return;
  }

  Serial.println("File Content:");

  while (file2.available())
  {

    Serial.write(file2.read());
  }

  file2.close();
}

void writeCalFile()
{
  File m_cal_file_to_write_name = SPIFFS.open("/calibration.JSON", FILE_WRITE);

  if (!m_cal_file_to_write_name)
  {
    Serial.println("There was an error opening the file for writing");
    return;
  }

  String m_calibration_string_to_write_JSON = "";
  m_calibration_string_to_write_JSON += "{\"acoeff\":";
  m_calibration_string_to_write_JSON += a_coeff;
  m_calibration_string_to_write_JSON += ",\"bcoeff\":";
  m_calibration_string_to_write_JSON += b_coeff;
  m_calibration_string_to_write_JSON += "}";

  Serial.println("Writing this JSON string to cal file:");
  Serial.println(m_calibration_string_to_write_JSON);

  if (!m_cal_file_to_write_name.println(m_calibration_string_to_write_JSON))
  {
    Serial.println("File write failed");
  }
  m_cal_file_to_write_name.close();
}

void readCalFile()
{
  File m_cal_file_name = SPIFFS.open("/calibration.JSON");

  if (!m_cal_file_name)
  {
    Serial.println("Failed to open cal file file for reading");
    return;
  }

  if (!SPIFFS.exists("/calibration.JSON"))
  {
    Serial.println("calibration.JSON does not exist, creating one.");
    writeCalFile();
    return;
  }

  // Serial.println("Cal file opened.");
  // Serial.println("File Content:");

  String secretsJson;
  while (m_cal_file_name.available()) // read json from file
  {
    secretsJson += char(m_cal_file_name.read());
  } //end while

  // Serial.println("Parsing cal file: ");
  // Serial.println(secretsJson);
  StaticJsonDocument<1000> m_JSONdoc_from_payload;
  DeserializationError m_error = deserializeJson(m_JSONdoc_from_payload, secretsJson); // m_JSONdoc is now a json object
  if (m_error)
  {
    Serial.println("deserializeJson() failed with code ");
    Serial.println(m_error.c_str());
  }
  //JsonObject m_JsonObject_from_payload = m_JSONdoc_from_payload.as<JsonObject>();
  a_coeff = m_JSONdoc_from_payload["acoeff"];
  b_coeff = m_JSONdoc_from_payload["bcoeff"];
  Serial.println("Cal file loaded with these parameters:");
  Serial.print("a_coeff = ");
  Serial.print(a_coeff);
  Serial.print(F("\t")); // tab
  Serial.print("b_coeff = ");
  Serial.println(b_coeff);

  m_cal_file_name.close();
}

bool readSSIDPWDfile(String m_pwd_filename_to_read)
{
  File m_pwd_file_to_read = SPIFFS.open(m_pwd_filename_to_read);

  if (!m_pwd_file_to_read)
  {
    Serial.println("Failed to open PWD file file for reading");
    return false;
  }

  if (!SPIFFS.exists(m_pwd_filename_to_read))
  {
    Serial.print(m_pwd_filename_to_read);
    Serial.println("  does not exist.");
    return false;
  }

  String m_pwd_file_string;
  while (m_pwd_file_to_read.available()) // read json from file
  {
    m_pwd_file_string += char(m_pwd_file_to_read.read());
  } //end while
  // Serial.print("m_pwd_file_string = ");
  // Serial.println(m_pwd_file_string);
  m_pwd_file_to_read.close();

  //parse
  StaticJsonDocument<1000> m_JSONdoc_from_pwd_file;
  DeserializationError m_error = deserializeJson(m_JSONdoc_from_pwd_file, m_pwd_file_string); // m_JSONdoc is now a json object
  if (m_error)
  {
    Serial.println("deserializeJson() failed with code ");
    Serial.println(m_error.c_str());
  }
  // m_JSONdoc_from_pwd_file is the JSON object now we can use it.
  String m_SSID1_name = m_JSONdoc_from_pwd_file["SSID1"];
  String m_SSID2_name = m_JSONdoc_from_pwd_file["SSID2"];
  String m_SSID3_name = m_JSONdoc_from_pwd_file["SSID3"];
  String m_PWD1_name = m_JSONdoc_from_pwd_file["PWD1"];
  String m_PWD2_name = m_JSONdoc_from_pwd_file["PWD2"];
  String m_PWD3_name = m_JSONdoc_from_pwd_file["PWD3"];
  // Serial.print("m_SSID1_name = ");
  // Serial.print(m_SSID1_name);
  // Serial.print(F("\t")); // tab
  // Serial.print("m_PWD1_name = ");
  // Serial.print(F("\t")); // tab
  // Serial.print("m_SSID2_name = ");
  // Serial.print(m_SSID2_name);
  // Serial.print(F("\t")); // tab
  // Serial.print("m_PWD2_name = ");
  // Serial.print(m_PWD2_name);
  // Serial.print(F("\t")); // tab
  // Serial.print("m_SSID3_name = ");
  // Serial.print(m_SSID3_name);
  // Serial.print(F("\t")); // tab
  // Serial.print("m_PWD3_name = ");
  // Serial.println(m_PWD3_name);

  // Try connecting:
  //****************************8
  if (connectAttempt(m_SSID1_name, m_PWD1_name))
  {
    return true;
  }
  Serial.println("Failed to connect.");
  if (connectAttempt(m_SSID2_name, m_PWD2_name))
  {
    return true;
  }
  Serial.println("Failed to connect.");

  if (connectAttempt(m_SSID3_name, m_PWD3_name))
  {
    return true;
  }
  Serial.println("Failed to connect.");

  return false;
}

void setUpAPService()
{
  Serial.println(F("Starting Access Point server."));

  // DNSServer dnsServer;
  // dnsServer.reset(new DNSServer());
  // APSTA：SoftAP 常开供从机连接；已连上的 STA（路由器）不会被关闭
  WiFi.mode(WIFI_AP_STA);
  // WiFi.softAPConfig(IPAddress(172, 217, 28, 1), IPAddress(172, 217, 28, 1), IPAddress(255, 255, 255, 0));
  WiFi.softAP("NanoStatAP", AP_PASSWORD, 0, 0, 4);
  delay(500);

  // 从机链路 TCP Server（从机作为 Client 连接）
  g_slaveServer.begin();

  Serial.print(F("[AP] NanoStatAP IP: "));
  Serial.println(WiFi.softAPIP());

  /* Setup the DNS server redirecting all the domains to the apIP */
  // dnsServer->setErrorReplyCode(DNSReplyCode::NoError);
  // dnsServer->start(DNS_PORT, "*", IPAddress(172, 217, 28, 1));

  //Serial.println("dns server config done");
}

void process()
{
  ///DNS
  // dnsServer->processNextRequest();
  //yield
  yield();
  delay(10);
  // Reset flag/timer
  if (restartSystem)
  {
    if (restartSystem + 1000 < millis())
    {
      ESP.restart();
    } //end if
  }   //end if
}

void handleGetSavSecreteJson(AsyncWebServerRequest *request)
{
  String message;

  String m_SSID1_name;
  String m_SSID2_name;
  String m_SSID3_name;
  String m_PWD1_name;
  String m_PWD2_name;
  String m_PWD3_name;
  String m_temp_string;
  int params = request->params();
  for (int i = 0; i < params; i++)
  {
    AsyncWebParameter *p = request->getParam(i);
    if (p->isPost())
    {
      Serial.print(i);
      Serial.print(F("\t"));
      Serial.print(p->name().c_str());
      Serial.print(F("\t"));
      Serial.println(p->value().c_str());
      m_temp_string = p->name().c_str();
      if (m_temp_string == "ssid1")
      {
        m_SSID1_name = p->value().c_str();
      }
      else if (m_temp_string == "pass1")
      {
        m_PWD1_name = p->value().c_str();
      }
      else if (m_temp_string == "ssid2")
      {
        m_SSID2_name = p->value().c_str();
      }
      else if (m_temp_string == "pass2")
      {
        m_PWD2_name = p->value().c_str();
      }
      else if (m_temp_string == "ssid3")
      {
        m_SSID3_name = p->value().c_str();
      }
      else if (m_temp_string == "pass3")
      {
        m_PWD3_name = p->value().c_str();
      }
    }
  }
  if (request->hasParam(PARAM_MESSAGE, true))
  {
    message = request->getParam(PARAM_MESSAGE, true)->value();
    Serial.println(message);
  }
  else
  {
    message = "No message sent";
  }
  request->send(200, "text/HTML", "Credentials saved. Rebooting...");

  // {"SSID1":"myssid1xyz","PWD1":"mypwd1xyz",
  //     "SSID2":"myssid2xyz","PWD2":"mypwd2xyz",
  //     "SSID3":"myssid3xyz","PWD3":"mypwd3xyz"}

  String SSID_and_pwd_JSON = "";
  SSID_and_pwd_JSON += "{\"SSID1\":\"";
  SSID_and_pwd_JSON += m_SSID1_name;
  SSID_and_pwd_JSON += "\",\"PWD1\":\"";
  SSID_and_pwd_JSON += m_PWD1_name;

  SSID_and_pwd_JSON += "\",\"SSID2\":\"";
  SSID_and_pwd_JSON += m_SSID2_name;
  SSID_and_pwd_JSON += "\",\"PWD2\":\"";
  SSID_and_pwd_JSON += m_PWD2_name;

  SSID_and_pwd_JSON += "\",\"SSID3\":\"";
  SSID_and_pwd_JSON += m_SSID3_name;
  SSID_and_pwd_JSON += "\",\"PWD3\":\"";
  SSID_and_pwd_JSON += m_PWD3_name;

  SSID_and_pwd_JSON += "\"}";

  Serial.println("JSON string to write to file = ");
  Serial.println(SSID_and_pwd_JSON);

  Serial.print("m_SSID1_name = ");
  Serial.print(m_SSID1_name);
  Serial.print(F("\t")); // tab
  Serial.print("m_PWD1_name = ");
  Serial.print(m_PWD1_name);
  Serial.print(F("\t")); // tab
  Serial.print("m_SSID2_name = ");
  Serial.print(m_SSID2_name);
  Serial.print(F("\t")); // tab
  Serial.print("m_PWD2_name = ");
  Serial.print(m_PWD2_name);
  Serial.print(F("\t")); // tab
  Serial.print("m_SSID3_name = ");
  Serial.print(m_SSID3_name);
  Serial.print(F("\t")); // tab
  Serial.print("m_PWD3_name = ");
  Serial.println(m_PWD3_name);

  File m_ssid_pwd_file_to_write_name = SPIFFS.open("/credentials.JSON", FILE_WRITE);

  if (!m_ssid_pwd_file_to_write_name)
  {
    Serial.println("There was an error opening the pwd/ssid file for writing");
    return;
  }

  Serial.println("Writing this JSON string to pwd/ssid file:");
  Serial.println(SSID_and_pwd_JSON);

  if (!m_ssid_pwd_file_to_write_name.println(SSID_and_pwd_JSON))
  {
    Serial.println("File write failed");
  }
  m_ssid_pwd_file_to_write_name.close();

  request->send(200, "text/html", "<h1>Restarting .....</h1>");
  restartSystem = millis();
}

void handleGetSavSecreteJsonNoReboot(AsyncWebServerRequest *request)
{
  String message;

  String m_SSID1_name;
  String m_SSID2_name;
  String m_SSID3_name;
  String m_PWD1_name;
  String m_PWD2_name;
  String m_PWD3_name;
  String m_temp_string;
  int params = request->params();
  for (int i = 0; i < params; i++)
  {
    AsyncWebParameter *p = request->getParam(i);
    if (p->isPost())
    {
      Serial.print(i);
      Serial.print(F("\t"));
      Serial.print(p->name().c_str());
      Serial.print(F("\t"));
      Serial.println(p->value().c_str());
      m_temp_string = p->name().c_str();
      if (m_temp_string == "ssid1")
      {
        m_SSID1_name = p->value().c_str();
      }
      else if (m_temp_string == "pass1")
      {
        m_PWD1_name = p->value().c_str();
      }
      else if (m_temp_string == "ssid2")
      {
        m_SSID2_name = p->value().c_str();
      }
      else if (m_temp_string == "pass2")
      {
        m_PWD2_name = p->value().c_str();
      }
      else if (m_temp_string == "ssid3")
      {
        m_SSID3_name = p->value().c_str();
      }
      else if (m_temp_string == "pass3")
      {
        m_PWD3_name = p->value().c_str();
      }
    }
  }
  if (request->hasParam(PARAM_MESSAGE, true))
  {
    message = request->getParam(PARAM_MESSAGE, true)->value();
    Serial.println(message);
  }
  else
  {
    message = "No message sent";
  }
  // request->send(200, "text/HTML", "bla bla bla bla bla xyz xyz xyz xyz xyz ");

  // {"SSID1":"myssid1xyz","PWD1":"mypwd1xyz",
  //     "SSID2":"myssid2xyz","PWD2":"mypwd2xyz",
  //     "SSID3":"myssid3xyz","PWD3":"mypwd3xyz"}

  String SSID_and_pwd_JSON = "";
  SSID_and_pwd_JSON += "{\"SSID1\":\"";
  SSID_and_pwd_JSON += m_SSID1_name;
  SSID_and_pwd_JSON += "\",\"PWD1\":\"";
  SSID_and_pwd_JSON += m_PWD1_name;

  SSID_and_pwd_JSON += "\",\"SSID2\":\"";
  SSID_and_pwd_JSON += m_SSID2_name;
  SSID_and_pwd_JSON += "\",\"PWD2\":\"";
  SSID_and_pwd_JSON += m_PWD2_name;

  SSID_and_pwd_JSON += "\",\"SSID3\":\"";
  SSID_and_pwd_JSON += m_SSID3_name;
  SSID_and_pwd_JSON += "\",\"PWD3\":\"";
  SSID_and_pwd_JSON += m_PWD3_name;

  SSID_and_pwd_JSON += "\"}";

  Serial.println("JSON string to write to file = ");
  Serial.println(SSID_and_pwd_JSON);

  Serial.print("m_SSID1_name = ");
  Serial.print(m_SSID1_name);
  Serial.print(F("\t")); // tab
  Serial.print("m_PWD1_name = ");
  Serial.print(m_PWD1_name);
  Serial.print(F("\t")); // tab
  Serial.print("m_SSID2_name = ");
  Serial.print(m_SSID2_name);
  Serial.print(F("\t")); // tab
  Serial.print("m_PWD2_name = ");
  Serial.print(m_PWD2_name);
  Serial.print(F("\t")); // tab
  Serial.print("m_SSID3_name = ");
  Serial.print(m_SSID3_name);
  Serial.print(F("\t")); // tab
  Serial.print("m_PWD3_name = ");
  Serial.println(m_PWD3_name);

  File m_ssid_pwd_file_to_write_name = SPIFFS.open("/credentials.JSON", FILE_WRITE);

  if (!m_ssid_pwd_file_to_write_name)
  {
    Serial.println("There was an error opening the pwd/ssid file for writing");
    return;
  }

  Serial.println("Writing this JSON string to pwd/ssid file:");
  Serial.println(SSID_and_pwd_JSON);

  if (!m_ssid_pwd_file_to_write_name.println(SSID_and_pwd_JSON))
  {
    Serial.println("File write failed");
  }
  m_ssid_pwd_file_to_write_name.close();

  request->send(200, "text/html", "  <head> <meta http-equiv=\"refresh\" content=\"2; URL=system.html#wifi\" /> <meta name=\"viewport\" content=\"width=device-width, initial-scale=1.0\"> </head> <body> <h1> Credentials stored to flash on NanoStat. </h1>  </body>");
  restartSystem = millis();
}

void handleFileList(AsyncWebServerRequest *request)
{
  Serial.println("handle fle list");
  if (!request->hasParam("dir"))
  {
    request->send(500, "text/plain", "BAD ARGS");
    return;
  }

  AsyncWebParameter *p = request->getParam("dir");
  String path = p->value().c_str();
  Serial.println("handleFileList: " + path);
  String output = "[";

  File root = SPIFFS.open("/", "r");
  if (root.isDirectory())
  {
    Serial.println("here ??");
    File file = root.openNextFile();
    while (file)
    {
      if (output != "[")
      {
        output += ',';
      }
      output += "{\"type\":\"";
      output += (file.isDirectory()) ? "dir" : "file";
      output += "\",\"name\":\"";
      output += String(file.name()).substring(0);
      output += "\"}";
      file = root.openNextFile();
    }
  }

  path = String();
  output += "]";
  Serial.println("Sending file list to client.");
  // Serial.println(output);
  request->send(200, "application/json", output);
}

void handleUpload(AsyncWebServerRequest *request, String filename, String redirect, size_t index, uint8_t *data, size_t len, bool final)
{
  Serial.println("handleUpload called");
  Serial.println(filename);
  Serial.println(redirect);
  // 上传句柄必须跨分片保留：ESPAsyncWebServer 会多次调用本回调
  static File fsUploadFile;
  if (!index)
  {
    if (!filename.startsWith("/"))
      filename = "/" + filename;
    Serial.println((String) "UploadStart: " + filename);
    fsUploadFile = SPIFFS.open(filename, "w"); // Open the file for writing in SPIFFS (create if it doesn't exist)
  }
  for (size_t i = 0; i < len; i++)
  {
    fsUploadFile.write(data[i]);
    // Serial.write(data[i]);
  }
  if (final)
  {
    Serial.println((String) "UploadEnd: " + filename);
    fsUploadFile.close();

    request->send(200, "text/HTML", "  <head> <meta http-equiv=\"refresh\" content=\"2; URL=system.html#files\" /> <meta name=\"viewport\" content=\"width=device-width, initial-scale=1.0\"> </head> <body> <h1> File uploaded! </h1> <p> Returning to file page. </p> </body>");

    // request->redirect(redirect);
  }
}

// handle the upload of the firmware
void handleFirmwareUpload(AsyncWebServerRequest *request, String filename, size_t index, uint8_t *data, size_t len, bool final)
{
  // handle upload and update
  if (!index)
  {
    Serial.printf("Update: %s\n", filename.c_str());
    if (!Update.begin(UPDATE_SIZE_UNKNOWN))
    { //start with max available size
      Update.printError(Serial);
    }
  }

  /* flashing firmware to ESP*/
  if (len)
  {
    Update.write(data, len);
  }

  if (final)
  {
    if (Update.end(true))
    { //true to set the size to the current progress
      Serial.printf("Update Success: %ub written\nRebooting...\n", index + len);
    }
    else
    {
      Update.printError(Serial);
    }
  }
  // alternative approach
  // https://github.com/me-no-dev/ESPAsyncWebServer/issues/542#issuecomment-508489206
}

// handle the upload of the firmware
void handleFilesystemUpload(AsyncWebServerRequest *request, String filename, size_t index, uint8_t *data, size_t len, bool final)
{
  // handle upload and update
  if (!index)
  {
    Serial.printf("Update: %s\n", filename.c_str());
    // if (!Update.begin(UPDATE_SIZE_UNKNOWN))
    if (!Update.begin(SPIFFS.totalBytes(), U_SPIFFS))
    { //start with max available size
      Update.printError(Serial);
    }
  }

  /* flashing firmware to ESP*/
  if (len)
  {
    Update.write(data, len);
  }

  if (final)
  {
    if (Update.end(true))
    { //true to set the size to the current progress
      Serial.printf("Update Success: %ub written\nRebooting...\n", index + len);
    }
    else
    {
      Update.printError(Serial);
    }
  }
  // alternative approach
  // https://github.com/me-no-dev/ESPAsyncWebServer/issues/542#issuecomment-508489206
}

void getWifiScanJson(AsyncWebServerRequest *request)
{
  String json = "{\"scan_result\":[";
  int n = WiFi.scanComplete();
  if (n == -2)
  {
    WiFi.scanNetworks(true);
  }
  else if (n)
  {
    for (int i = 0; i < n; ++i)
    {
      if (i)
        json += ",";
      json += "{";
      json += "\"RSSI\":" + String(WiFi.RSSI(i));
      json += ",\"SSID\":\"" + WiFi.SSID(i) + "\"";
      json += "}";
    }
    WiFi.scanDelete();
    if (WiFi.scanComplete() == -2)
    {
      WiFi.scanNetworks(true);
    }
  }
  json += "]}";
  request->send(200, "application/json", json);
  json = String();
}

void runWifiPortal()
{

  m_wifitools_server.reset(new AsyncWebServer(80));

  IPAddress myIP;
  myIP = WiFi.softAPIP();
  // myIP = WiFi.localIP();
  Serial.print(F("AP IP address: "));
  Serial.println(myIP);

  // Need to tell server to accept packets from any source with any header via http methods GET, PUT:
  DefaultHeaders::Instance().addHeader("Access-Control-Allow-Origin", "*");
  DefaultHeaders::Instance().addHeader("Access-Control-Allow-Methods", "GET, PUT");
  DefaultHeaders::Instance().addHeader("Access-Control-Allow-Headers", "*");

  m_wifitools_server->serveStatic("/", SPIFFS, "/").setDefaultFile("wifi_index.html");

  // m_wifitools_server->on("/saveSecret/", HTTP_ANY, [&, this](AsyncWebServerRequest *request) {
  //   handleGetSavSecreteJson(request);
  // });

  m_wifitools_server->on("/saveSecret", HTTP_POST, [](AsyncWebServerRequest *request)
                         { handleGetSavSecreteJson(request); });

  m_wifitools_server->on("/list", HTTP_ANY, [](AsyncWebServerRequest *request)
                         { handleFileList(request); });

  m_wifitools_server->on("/wifiScan.json", HTTP_GET, [](AsyncWebServerRequest *request)
                         { getWifiScanJson(request); });

  //xyzxyzxyzxyzxyzxyzxyzxyzxyzxyzxyzxyzxyzxyzxyzxyzxyzxyzxyzxyzxyzxyzxyzxyzxyzxyzxyzxyzxyzxyzxyzxyzxyzxyz

  // m_wifitools_server->on("/saveSecret/", HTTP_ANY, [&, this](AsyncWebServerRequest *request) {
  //   handleGetSavSecreteJson(request);
  // });

  // m_wifitools_server->on("/list", HTTP_ANY, [&, this](AsyncWebServerRequest *request) {
  //   handleFileList(request);
  // });

  // // spiff delete
  // m_wifitools_server->on("/edit", HTTP_DELETE, [&, this](AsyncWebServerRequest *request) {
  //   handleFileDelete(request);
  // });

  // // spiff upload
  // m_wifitools_server->on(
  //     "/edit", HTTP_POST, [&, this](AsyncWebServerRequest *request) {},
  //     [&, this](AsyncWebServerRequest *request, const String &filename, size_t index, uint8_t *data,
  //               size_t len, bool final) {
  //       handleUpload(request, filename, "/wifi_spiffs_admin.html", index, data, len, final);
  //     });

  // m_wifitools_server->on("/wifiScan.json", HTTP_GET, [&, this](AsyncWebServerRequest *request) {
  //   getWifiScanJson(request);
  // });

  // // Simple Firmware Update Form
  // m_wifitools_server->on("/update", HTTP_GET, [&, this](AsyncWebServerRequest *request) {
  //   request->send(SPIFFS, "/wifi_upload.html");
  // });
  // m_wifitools_server->on(
  //     "/update", HTTP_POST, [&, this](AsyncWebServerRequest *request) {
  //       uint8_t isSuccess = !Update.hasError();
  //       if (isSuccess)
  //         restartSystem = millis();
  //       AsyncWebServerResponse *response = request->beginResponse(200, "text/plain", isSuccess ? "OK" : "FAIL");
  //       response->addHeader("Connection", "close");
  //       request->send(response); },
  //     [&, this](AsyncWebServerRequest *request, String filename, size_t index, uint8_t *data, size_t len, bool final) {
  //       if (!index)
  //       {
  //         Serial.printf("Update Start: %s\n", filename.c_str());

  //         if (!Update.begin(UPDATE_SIZE_UNKNOWN))
  //         {
  //           Update.printError(Serial);
  //         }
  //       }
  //       if (!Update.hasError())
  //       {
  //         if (Update.write(data, len) != len)
  //         {
  //           Update.printError(Serial);
  //         }
  //       }
  //       if (final)
  //       {
  //         if (Update.end(true))
  //         {
  //           Serial.printf("Update Success: %uB\n", index + len);
  //         }
  //         else
  //         {
  //           Update.printError(Serial);
  //         }
  //       }
  //     });

  // m_wifitools_server->on("/restart", HTTP_GET, [&, this](AsyncWebServerRequest *request) {
  //   request->send(200, "text/html", "OK");
  //   restartSystem = millis();
  // });

  // m_wifitools_server->onNotFound([](AsyncWebServerRequest *request) {
  //   Serial.println("handle not found");
  //   request->send(404);
  // });

  // m_wifitools_server->addHandler(new CaptiveRequestHandler()).setFilter(ON_AP_FILTER); //only when requested from AP

  //xyzxyzxyzxyzxyzxyzxyzxyzxyzxyzxyzxyzxyzxyzxyzxyzxyzxyzxyzxyzxyzxyzxyzxyzxyzxyzxyzxyzxyzxyzxyzxyzxyzxyz

  Serial.println(F("HTTP server started"));
  m_wifitools_server->begin();
  if (!MDNS.begin("nanostat")) // see https://randomnerdtutorials.com/esp32-access-point-ap-web-server/
  {
    Serial.println("Error setting up MDNS responder !");
    while (1)
      ;
    {
      delay(1000);
    }
  }
  Serial.println("MDNS started.");
  // MDNS.begin("nanostat");
  while (1) // loop until user hits restart... Once credentials saved, won't end up here again unless wifi not connecting!
  {
    process();
  }
}

void runWifiPortal_after_connected_to_WIFI()
{
  // Don't run this after starting server or ESP32 will crash!!!
  server.on("/saveSecret/", HTTP_POST, [](AsyncWebServerRequest *request)
            { handleGetSavSecreteJsonNoReboot(request); });

  //xyzxyzxyzxyzxyzxyzxyzxyzxyzxyzxyzxyzxyzxyzxyzxyzxyzxyzxyzxyzxyzxyzxyzxyzxyzxyzxyzxyzxyzxyzxyzxyzxyzxyz

  // m_wifitools_server->on("/saveSecret/", HTTP_ANY, [&, this](AsyncWebServerRequest *request) {
  //   handleGetSavSecreteJson(request);
  // });

  // m_wifitools_server->on("/list", HTTP_ANY, [&, this](AsyncWebServerRequest *request) {
  //   handleFileList(request);
  // });

  // // spiff delete
  // m_wifitools_server->on("/edit", HTTP_DELETE, [&, this](AsyncWebServerRequest *request) {
  //   handleFileDelete(request);
  // });

  // // spiff upload
  // m_wifitools_server->on(
  //     "/edit", HTTP_POST, [&, this](AsyncWebServerRequest *request) {},
  //     [&, this](AsyncWebServerRequest *request, const String &filename, size_t index, uint8_t *data,
  //               size_t len, bool final) {
  //       handleUpload(request, filename, "/wifi_spiffs_admin.html", index, data, len, final);
  //     });

  // m_wifitools_server->on("/wifiScan.json", HTTP_GET, [&, this](AsyncWebServerRequest *request) {
  //   getWifiScanJson(request);
  // });

  // // Simple Firmware Update Form
  // m_wifitools_server->on("/update", HTTP_GET, [&, this](AsyncWebServerRequest *request) {
  //   request->send(SPIFFS, "/wifi_upload.html");
  // });
  // m_wifitools_server->on(
  //     "/update", HTTP_POST, [&, this](AsyncWebServerRequest *request) {
  //       uint8_t isSuccess = !Update.hasError();
  //       if (isSuccess)
  //         restartSystem = millis();
  //       AsyncWebServerResponse *response = request->beginResponse(200, "text/plain", isSuccess ? "OK" : "FAIL");
  //       response->addHeader("Connection", "close");
  //       request->send(response); },
  //     [&, this](AsyncWebServerRequest *request, String filename, size_t index, uint8_t *data, size_t len, bool final) {
  //       if (!index)
  //       {
  //         Serial.printf("Update Start: %s\n", filename.c_str());

  //         if (!Update.begin(UPDATE_SIZE_UNKNOWN))
  //         {
  //           Update.printError(Serial);
  //         }
  //       }
  //       if (!Update.hasError())
  //       {
  //         if (Update.write(data, len) != len)
  //         {
  //           Update.printError(Serial);
  //         }
  //       }
  //       if (final)
  //       {
  //         if (Update.end(true))
  //         {
  //           Serial.printf("Update Success: %uB\n", index + len);
  //         }
  //         else
  //         {
  //           Update.printError(Serial);
  //         }
  //       }
  //     });

  // m_wifitools_server->on("/restart", HTTP_GET, [&, this](AsyncWebServerRequest *request) {
  //   request->send(200, "text/html", "OK");
  //   restartSystem = millis();
  // });

  // m_wifitools_server->onNotFound([](AsyncWebServerRequest *request) {
  //   Serial.println("handle not found");
  //   request->send(404);
  // });

  // m_wifitools_server->addHandler(new CaptiveRequestHandler()).setFilter(ON_AP_FILTER); //only when requested from AP

  //xyzxyzxyzxyzxyzxyzxyzxyzxyzxyzxyzxyzxyzxyzxyzxyzxyzxyzxyzxyzxyzxyzxyzxyzxyzxyzxyzxyzxyzxyzxyzxyzxyzxyz

  Serial.println(F("HTTP server started"));
  m_wifitools_server->begin();
  if (!MDNS.begin("nanostat")) // see https://randomnerdtutorials.com/esp32-access-point-ap-web-server/
  {
    Serial.println("Error setting up MDNS responder !");
    while (1)
      ;
    {
      delay(1000);
    }
  }
  Serial.println("MDNS started.");
  // MDNS.begin("nanostat");
  while (1) // loop until user hits restart... Once credentials saved, won't end up here again unless wifi not connecting!
  {
    process();
  }
}

void listDir(const char *dirname, uint8_t levels)
{
  // from https://github.com/espressif/arduino-esp32/blob/master/libraries/SPIFFS/examples/SPIFFS_Test/SPIFFS_Test.ino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
  // see also https://techtutorialsx.com/2019/02/24/esp32-arduino-listing-files-in-a-spiffs-file-system-specific-path/
  Serial.printf("Listing directory: %s\r\n", dirname);

  File root = SPIFFS.open(dirname);
  if (!root)
  {
    Serial.println("- failed to open directory");
    return;
  }
  if (!root.isDirectory())
  {
    Serial.println(" - not a directory");
    return;
  }

  File file = root.openNextFile();
  while (file)
  {

    Serial.print("  FILE: ");
    Serial.print(file.name());
    Serial.print("\tSIZE: ");
    Serial.println(file.size());

    file = root.openNextFile();
  }
}

void reset_Voltammogram_arrays()
{
  for (uint16_t i = 0; i < arr_samples; i++)
  {
    volts[i] = 0;
    amps[i] = 0;
    time_Voltammaogram[i] = 0;
  }
}

inline void saveVoltammogram(float voltage, float current, bool debug)
{
  //@param        voltage: voltage or time depending on type of experiment
  //                       voltage for voltammetry, time for time for
  //                       time evolution experiments like chronoamperometry
  //@param        current: current from the electrochemical cell

  //
  volts[arr_cur_index] = (int16_t)voltage;
  amps[arr_cur_index] = current;
  time_Voltammaogram[arr_cur_index] = millis();
  arr_cur_index++;
  number_of_valid_points_in_volts_amps_array++;

  if (debug)
  {
    Serial.println(" ");
    Serial.println("****************** SAVING TO VOLTAMMOGRAM******************");
    Serial.print("arr_cur_index=");
    Serial.println(arr_cur_index);
    Serial.print(voltage);
    Serial.print(F("\t"));
    Serial.print(current, 5);
    Serial.print(F("\t"));
    Serial.println(micros());
    Serial.println("****************** SAVED TO VOLTAMMOGRAM******************");
    Serial.println(" ");
  }
}
void testIV(int16_t startV, int16_t endV, int16_t numPoints,
            uint32_t delayTime_ms)
{
  //@param      startV:       voltage to start the scan
  //@param      endV:         voltage to stop the scan
  //@param      numPoints:    number of points in the scan
  //@param      delayTime_ms:  settle time after set point
  //
  // Measures IV curve.

  float i_forward = 0;
  uint32_t voltage_step;
  lastTime = millis();
  //Reset Arrays
  reset_Voltammogram_arrays(); // sets volt[i], amps[i],time_Voltammaogram[i]=0 all
  arr_cur_index = 0;
  number_of_valid_points_in_volts_amps_array = 0;

  voltage_step = (endV - startV) / numPoints;
  if (voltage_step == 0)
  {
    voltage_step = 1; // 1 mV minimum
  }

  Serial.println("******************************************************");
  Serial.println("Starting IV sweep with these parameters:");
  Serial.println(startV);
  Serial.println(endV);
  Serial.println(numPoints);
  Serial.println(voltage_step);
  Serial.print("Heap free memory (in bytes)= ");
  Serial.println(ESP.getFreeHeap());

  // Initialize LMP91000:
  initLMP(LMPgainGLOBAL);
  setLMPBias(startV);
  setVoltage(startV);

  //xxxxxxxxxxxxxxxxxxxxxxxxxx
  if (print_output_to_serial)
  {
    Serial.println("RUNNING TEST IV:");
    Serial.print("a_coeff =");
    Serial.println(a_coeff);
    Serial.print("b_coeff =");
    Serial.println(b_coeff);
    Serial.print("startV =");
    Serial.println(startV);
    Serial.print("endV =");
    Serial.println(endV);
    Serial.print("numPoints =");
    Serial.println(numPoints);
    Serial.print("delayTime_ms =");
    Serial.println(delayTime_ms);
    Serial.print("voltage_step =");
    Serial.println(voltage_step);

    Serial.println("Column header meanings:");
    Serial.println("BIAS:");
    Serial.println("T = time in ms");
    Serial.println("Vc = desired cell voltage in mV (internal variable name = voltage)");
    Serial.println("Vset = set cell voltage in mV (internal variable name = vset = dacVout * TIA_BIAS[bias_setting])");
    Serial.println("div = percentage scale (internal variable name = TIA_BIAS[bias_setting])");
    Serial.println("Vdac = ESP32 dac voltage in mV (internal variable name = dacVout)");
    Serial.println("adcbits = analogread(LMP)");
    Serial.println("Vout = TIA output in mV (internal variable name = v1 = pStat.getVoltage(analogRead(LMP), opVolt, adcBits);");
    Serial.println("Vc1 = internal zero in mV also C1 (internal variable name = v2 = dacVout * .5)");
    Serial.println("i_f = forward current in uA (internal variable name = current = (((v1 - v2) / 1000) / TIA_GAIN[LMPgain - 1]) * pow(10, 6); //scales to uA)");

    // Serial.println("xyz = xyz in xyz (internal variable name = xyz)");
    // Serial.println("xyz = xyz in xyz (internal variable name = v)");

    Serial.println("T\tVc\tVset\tdiv\tVdac\tadcbits\tVout\tVc1\ti_f");
    // Serial.println("T,Vc,Vset,div,Vdac,adcbits,Vout,Vc1,i_f");
  }

  for (int16_t this_voltage = startV; this_voltage <= endV; this_voltage += voltage_step)
  {
    i_forward = biasAndSample(this_voltage, delayTime_ms);
    saveVoltammogram(this_voltage, i_forward, false);
    if (print_output_to_serial)
    {
      Serial.println("EOL");
    }
    if (userpause) //will hold the code here until a character is sent over the Serial port
    {
      while (!Serial.available())
        ;
      Serial.read();
    }
  }
  setOutputsToZero();
  Serial.println("Finished IV sweep.");
  Serial.print("Heap free memory (in bytes)= ");
  Serial.println(ESP.getFreeHeap());
  Serial.println("******************************************************");
}

void testNoiseAtABiasPoint(int16_t biasV, int16_t numPoints,
                           uint32_t delayTime_ms)
{
  // sets call voltage to biasV using  setVoltage(biasV) only at beginning
  // then "reads" ADC numPoints times using analog_read_avg(num_readings_to_average, LMP); where each reading is an average
  // gives std_dev
  // internally iterates averages per reading to get idea how it effects noise...
  // dumps output to serial

  //Reset Arrays
  reset_Voltammogram_arrays(); // sets volt[i], amps[i],time_Voltammaogram[i]=0 all
  number_of_valid_points_in_volts_amps_array = 0;
  arr_cur_index = 0;

  // local variables for statistics:
  float adc_bits_array[numPoints];
  Serial.print("Heap free memory (in bytes)= ");
  Serial.println(ESP.getFreeHeap());
  float adc_bits_array_sum = 0;
  float adc_bits_array_avg = 0;
  float adc_bits_array_std_dev = 0;
  float adc_bits_minus_avg_squared_sum = 0;
  int num_readings_to_average = 1;

  // which num point to avg:
  float num_points_to_average[7] = {1, 5, 10, 50, 100, 500, 1000};

  // set LMP91000 and bias
  initLMP(LMPgainGLOBAL);
  setLMPBias(biasV);
  setVoltage(biasV);

  if (print_output_to_serial)
  {
    Serial.print("num_rdgs");
    Serial.print(F("\t"));

    Serial.print("adc_avg");
    Serial.print(F("\t"));

    Serial.println("adc_std_dev");
  };

  for (int16_t i = 0; i < 7; i += 1) // iterate over # of pts per reading
  {
    adc_bits_array_sum = 0;
    adc_bits_array_avg = 0;
    adc_bits_array_std_dev = 0;
    adc_bits_minus_avg_squared_sum = 0;
    num_readings_to_average = num_points_to_average[i];

    for (int16_t j = 0; j < numPoints; j += 1) // read the adc data
    {
      //handle pulsing and delay
      if (delayTime_ms > 10) // we can afford the time to pulse the LED for 10 ms, just waiting anyways
      {
        pulseLED_on_off(LEDPIN, 10); // signify start of a new data point
        delay(delayTime_ms - 10);
      }
      else if (delayTime_ms < 10) // we cannot afford the time to pulse the LED for 10 ms, so pulse 1 ms only
      {
        if (delayTime_ms > 2)
        {
          pulseLED_on_off(LEDPIN, 1); // signify start of a new data point
          delay(delayTime_ms - 1);
        }
        else if (delayTime_ms < 2)
        { // no LED pulse too fast....
          delay(delayTime_ms);
        }
      }
      adc_bits_array[j] = analog_read_avg(num_readings_to_average, LMP);
      //pulseLED_on_off(LEDPIN, 10);
      // Now populate Volts array etc:
      volts[arr_cur_index] = biasV;
      time_Voltammaogram[arr_cur_index] = millis();
      amps[arr_cur_index] = adc_bits_array[j];
      arr_cur_index++;
      number_of_valid_points_in_volts_amps_array++;
    }
    for (int16_t j = 0; j < numPoints; j += 1) // calculate the average
    {
      adc_bits_array_sum += adc_bits_array[j];
    }
    adc_bits_array_avg = adc_bits_array_sum / numPoints;
    for (int16_t j = 0; j < numPoints; j += 1) // calculate the std deviation
    {
      adc_bits_minus_avg_squared_sum += (adc_bits_array_avg - adc_bits_array[j]) * (adc_bits_array_avg - adc_bits_array[j]);
    }
    adc_bits_array_std_dev = sqrt(adc_bits_minus_avg_squared_sum / numPoints);

    if (print_output_to_serial)
    {
      Serial.print(num_readings_to_average);
      Serial.print(F("\t"));

      Serial.print(adc_bits_array_avg);
      Serial.print(F("\t"));

      Serial.println(adc_bits_array_std_dev);
    }
  }
}

void testDACs(uint32_t delayTime_ms)
{

  // steps ESP32 DAC from 0 to 255 digital so you can check it on a multimeter

  //xxxxxxxxxxxxxxxxxxxxxxxxxx

  initLMP(LMPgainGLOBAL);
  setLMPBias(100);
  setVoltage(100);

  //xxxxxxxxxxxxxxxxxxxxxxxxxx
  Serial.println("RUNNING TEST DAC:");

  Serial.println("i\tdacgoal");

  float dacgoal;
  for (int16_t j = 0; j <= 255; j += 1)
  {
    dacWrite(dac, j); // sets ESP32 DAC bits
    dacgoal = 3300.0 * j / 255;
    Serial.print(j); // current time in ms
    Serial.print(F("\t"));
    Serial.println(dacgoal); // desired cell voltage
    if (userpause)           //will hold the code here until a character is sent over the Serial port
    {
      while (!Serial.available())
        ;
      Serial.read();
    }
  }
  setOutputsToZero();
}

void testDACandADCs(uint32_t delayTime_ms)
{

  // steps ESP32 DAC from 0 to 255 digital so you can check it on a multimeter
  // measures with ADC
  // prints to serial
  float adc_voltage;

  //xxxxxxxxxxxxxxxxxxxxxxxxxx

  initLMP(LMPgainGLOBAL);
  setLMPBias(100);
  setVoltage(100);

  //xxxxxxxxxxxxxxxxxxxxxxxxxx
  Serial.println("RUNNING TEST DAC:");

  Serial.println("i\tdacgoal\tadc_voltage xyz");

  float dacgoal;
  for (int16_t j = 0; j <= 255; j += 1)
  {
    pulseLED_on_off(LEDPIN, 10); // signify start of a new data point
    // dacWrite(dac, j); // sets ESP32 DAC bits
    dacWrite(dac, j); // sets ESP32 DAC bits
    // dacgoal = 3300.0 * j / 255;
    dacgoal = 3300.0 * 136 / 255;
    delay(delayTime_ms);
    // read ADC....
    adc_voltage = analogRead(LMP);
    Serial.print(j); // current time in ms
    Serial.print(F("\t"));
    Serial.print(dacgoal); // desired cell voltage
    Serial.print(F("\t"));
    Serial.println(adc_voltage); // adc voltage

    if (userpause) //will hold the code here until a character is sent over the Serial port
    {
      while (!Serial.available())
        ;
      Serial.read();
    }
  }
  setOutputsToZero();
}

void calibrateDACandADCs(uint32_t delayTime_ms)
{

  // Sets LMP91000 gain to 0%, so at Vout, voltage is always 0.5 * Vref. (Assumes WE floating so no WE current!)
  // Stores results (slope/offset calibration points) in global variables    a_coeff, b_coeff
  // Note probably need to do it for each TIA gain setting, hard coded to 7 ie. RTIA=350kohm for now.
  // Vout=DAC, Vref=ADC
  // Run DAC from 1.5 to 3 volts (in digital units with 8 bits, 116 to 255 bit)
  // Read ADC over same range. Have ADC calibratoin for DAC range.
  // Will use to correct as follows:
  // Fit ADC/2 vs DAC and return call coefficients....
  // To run: 1) Disconnect WE from RE/CE; 2) Run calibrateDACandADCs; 3) Reconnect; 4) Run testIV (biasandsample uses coefficients)
  // Temporarily, click CV button on website for step 2 and NPV for step 4 (hardwired, later to fix UI for this...)

  float dacgoal;
  int this_voltage_adc;

  //xxxxxxxxxxxxxxxxxxxxxxxxxx
  pStat.disableFET();
  pStat.setGain(LMPgainGLOBAL); // TIA feedback resistor , global variable
  pStat.setRLoad(0);
  pStat.setExtRefSource();
  pStat.setIntZ(1);
  pStat.setThreeLead();
  pStat.setBias(0);
  pStat.setNegBias();
  pStat.setBias(0); // sets percentage voltage divider in LMP910000
                    // TIA_BIAS[bias_setting] varies from 1% to 22% depending on setting; note initially set to 0%...
                    // from LMP91000.h:
                    //const double TIA_BIAS[] = {0, 0.01, 0.02, 0.04, 0.06, 0.08, 0.1, 0.12, 0.14,
                    //    0.16, 0.18, 0.2, 0.22, 0.24};
                    //xxxxxxxxxxxxxxxxxxxxxxxxxx

  //xxxxxxxxxxxxxxxxxxxxxxxxxx
  Serial.println("RUNNING TEST ADC CAL LMP91000:");
  Serial.println("TIA_BIAS[0]=");
  Serial.println(TIA_BIAS[0]);

  // int adc_int_from_dac_int[140]; // for dac 116 to 255, what adc reads
  // assuming cell is open, no current, ADC is reading vout which is also WE voltage if no current
  // WE voltage is supposed to be 0.5* Vref, and Vref is DAC

  float sumonx = 0;
  float sumony = 0;
  float sumonxy = 0;
  float sumonxsquared = 0;
  float sumonysquared = 0;
  float n = 0;
  float a = 0;
  float b = 0;

  for (int16_t j = 116; j <= 255; j += 1) // want to go from 1.5 to 3.3 V
  // 1.5 V is (1.5/3.3)*255 = 115.909 = 116 for 8 bit dac
  {
    dacWrite(dac, j); // sets ESP32 DAC bits
    if (j == 116)
    {
      delay(250);
    }
    // read analog voltage which should be half of dac voltage...
    this_voltage_adc = analogRead(LMP);
    // adc_int_from_dac_int[j - 116] = this_voltage_adc;
    dacgoal = 3300.0 * j / 255;
    if (print_output_to_serial)
    {
      Serial.print(j);
      Serial.print(F("\t"));
      Serial.print(dacgoal);
      Serial.print(F("\t"));
      Serial.println(this_voltage_adc); // desired cell voltage
    }

    if (userpause) //will hold the code here until a character is sent over the Serial port
    {
      while (!Serial.available())
        ;
      Serial.read();
    }
    // now fill in statistics:
    sumonx += j;
    sumony += this_voltage_adc;
    sumonxy += j * this_voltage_adc;
    sumonxsquared += j * j;
    sumonysquared += this_voltage_adc * this_voltage_adc;
    n += 1;
  }

  // now I want to fit a line to adc_int_from_dac_int[i] vs i....
  // https://www.statisticshowto.com/probability-and-statistics/regression-analysis/find-a-linear-regression-equation/
  // y=a+bx
  // y=adc
  // x=dac
  // sumonx=
  // sumony=
  // sumonxy=
  // sumonxsquared=
  // sumonysquared=
  // n=
  // a= ((sumony)*(sumonxsquared)-(sumonx)*(sumonxy))/(n*(sumonxsquared)-(sumonx)*(sumonx))
  // b= (n*(sumonxy) - (sumonx)*(sumony))/(n*(sumonxsquared)-(sumonx)*(sumonx))
  a = ((sumony) * (sumonxsquared) - (sumonx) * (sumonxy)) / (n * (sumonxsquared) - (sumonx) * (sumonx));
  b = (n * (sumonxy) - (sumonx) * (sumony)) / (n * (sumonxsquared) - (sumonx) * (sumonx));
  Serial.println("y=a + bx");
  Serial.println("y=dac");
  Serial.println("y=adc");
  Serial.print("a=");
  Serial.println(a);
  Serial.print("b=");
  Serial.println(b);
  // so adc = a + b * dac
  // dac = bit # (0-255)
  // adc = bit # (0-4095)
  // so for calculation of actual voltage from adc, we can assume the calibration (taking dac as perfect)
  // dacvoltage = (dac/255)*3.3
  // adcvoltage = 0.5*dacvoltage
  // adc = a + b * dac = a + b * dacvoltage * (255/3.3); here dac voltage is assumed correct
  // so inverting, we get dacvoltage = (adc-a)*(3.3/255)*(1/b)
  // dacvoltage = ((3.3/255)*(1/b)) * adc + ((-a/b)*(3.3/255))
  // adcvoltage = ((3.3/255)*(1/2*b)) * adc + ((-a/2*b)*(3.3/255))

  a_coeff = a;
  b_coeff = b;
}

void testLMP91000(uint32_t delayTime_ms, uint8_t bias_setting_local)
{

  // PJB 4/12/2021
  // The purpose of this subroutine is to set the LMP91000 settings over the I2C
  // so that the user can manually apply an input (control)  voltage and
  // manually read the output voltages in a test breadboad.
  // It assumes the user has access to all LMP91000 pins on a breakout board of some kind, and
  // that the ESP32 controls the LMP910000 over the I2C interface.
  // For example, the ESP32 could be an ESP32 Pico Kit board, or any ESP32 board, with I2C
  // wired manually to the LMP91000.
  // P Burke made a breakout board of LMP91000 chips.

  // Parameters the user can set on LMP91000:
  // TIA gain (keep max at 350k feedback resistor)
  // Rload (keep at 10 ohms)
  // Ref source int/ext (keep ext)
  // Int_Z zero 50 20 67% (keep at 50%)
  // Bias_Sign (plus/minus)
  // Bias 1%-24%
  // FET_Short (keep off)
  // Mode (keep at 3-lead)

  bool loop_dac = false;
  float dacgoal;
  //xxxxxxxxxxxxxxxxxxxxxxxxxx
  pStat.disableFET();
  pStat.setGain(7); // TIA feedback resistor 350k
  pStat.setRLoad(0);
  pStat.setExtRefSource();
  pStat.setIntZ(1);
  pStat.setThreeLead();
  pStat.setBias(0);
  pStat.setNegBias();
  pStat.setBias(bias_setting_local); // sets percentage voltage divider in LMP910000
  // TIA_BIAS[bias_setting] varies from 1% to 22% depending on setting; note initially set to 0%...
  // from LMP91000.h:
  //const double TIA_BIAS[] = {0, 0.01, 0.02, 0.04, 0.06, 0.08, 0.1, 0.12, 0.14,
  //    0.16, 0.18, 0.2, 0.22, 0.24};
  //xxxxxxxxxxxxxxxxxxxxxxxxxx

  Serial.println("RUNNING TEST LMP91000:");
  Serial.println("TIA_BIAS[bias_setting_local]=");
  Serial.println(TIA_BIAS[bias_setting_local]);

  for (int16_t i = 0; i <= 13; i += 1) //loop over percentage of Vref applied to cell
  {
    pStat.setBias(i);
    Serial.println("****************************************");
    Serial.println("TIA_BIAS[i]=");
    Serial.println(TIA_BIAS[i]);
    if (userpause) //will hold the code here until a character is sent over the Serial port
    {
      while (!Serial.available())
        ;
      Serial.read();
    }
    if (loop_dac)
    {
      for (int16_t j = 0; j <= 255; j += 1)
      {
        dacWrite(dac, j); // sets ESP32 DAC bits
        dacgoal = 3300.0 * j / 255;
        Serial.print(j); // current time in ms
        Serial.print(F("\t"));
        Serial.println(dacgoal); // desired cell voltage
        if (userpause)           //will hold the code here until a character is sent over the Serial port
        {
          while (!Serial.available())
            ;
          Serial.read();
        }
      }
    }
  }
}

void runNPVForward(int16_t startV, int16_t endV, int8_t pulseAmp,
                   uint32_t pulse_width, uint32_t off_time)
{

  //@param      startV:       voltage to start the scan
  //@param      endV:         voltage to stop the scan
  //@param      pulseAmp:     amplitude of square wave
  //@param      pulse_width:  the pulse-width of the excitation voltage
  //@param      off_time:
  //
  //Runs NPV in the forward (oxidation) direction. The bias potential
  //is swept from a more negative voltage to a more positive voltage.

  float i_forward = 0;
  float i_backward = 0;

  for (int16_t j = startV; j <= endV; j += pulseAmp)
  {
    i_forward = biasAndSample(j, pulse_width);
    if (userpause) //will hold the code here until a character is sent over the Serial port
    {
      while (!Serial.available())
        ;
      Serial.read();
    }
    i_backward = biasAndSample(startV, off_time); // xxx comment out to do only forward bias

    saveVoltammogram(j, i_forward - i_backward, false); // this will print voltage, current
    if (print_output_to_serial)
    {
      Serial.println("EOL");
    }
    // Serial.println();
    // if (userpause) //will hold the code here until a character is sent over the Serial port
    // {
    //   while (!Serial.available())
    //     ;
    //   Serial.read();
    // }
  }
}

void runNPVBackward(int16_t startV, int16_t endV, int8_t pulseAmp,
                    uint32_t pulse_width, uint32_t off_time)
{
  //@param      startV:       voltage to start the scan
  //@param      endV:         voltage to stop the scan
  //@param      pulseAmp:     amplitude of square wave
  //@param      pulse_width:  the pulse-width of the excitation voltage
  //@param      off_time:
  //
  //Runs NPV in the reverse (reduction) direction. The bias potential
  //is swept from a more positivie voltage to a more negative voltage.

  float i_forward = 0;
  float i_backward = 0;

  for (int16_t j = startV; j >= endV; j -= pulseAmp)
  {
    i_forward = biasAndSample(j, pulse_width);
    //will hold the code here until a character is sent over the Serial port
    //this ensures the experiment will only run when initiated
    while (!Serial.available())
      ;
    Serial.read();
    i_backward = biasAndSample(startV, off_time);
    saveVoltammogram(j, i_forward - i_backward, false); // this will print voltage, current

    //will hold the code here until a character is sent over the Serial port
    //this ensures the experiment will only run when initiated
    while (!Serial.available())
      ;
    Serial.read();
    saveVoltammogram(j, i_forward - i_backward, true); // this will print voltage, currnt
    // Serial.println();
  }
}
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
void loop()
{

  //will hold the code here until a character is sent over the Serial port
  //this ensures the experiment will only run when initiated
  //  Serial.println(F("Press enter to begin a sweep."));
  //  while (!Serial.available())
  //    ;
  //  Serial.read();
  // Look for and handle WebSocket data

  m_websocketserver.loop();

  // ===== 新增：从机通信 + 实验调度（非阻塞，每圈都要跑）=====
  slaveLoop();
  serviceExperiment();
  timeSyncTick();   // 统一时钟：STA 在线时自动 NTP 对时

  if (m_send_websocket_test_data_in_loop == true) // do things here in loop at full speed
  {
    // Pseudocode: xxx_period_in_ms_xxx=period_in_s * 1e3 = (1/freqHz)*1e3
    if (millis() - last_time_sent_websocket_server > (1000 / m_websocket_send_rate)) // every half second, print
    {
      //    sendTimeOverWebsocketJSON();
      sendValueOverWebsocketJSON(100 * 0.5 * sin(millis() / 1e3)); // value is sine wave of time , frequency 0.5 Hz, amplitude 100.
      last_time_sent_websocket_server = millis();
    }
    // m_microsbefore_websocketsendcalled=micros();
    // sendTimeOverWebsocketJSON(); // takes 2.5 ms on average, when client is connected, else 45 microseconds...
    // Serial.println(micros()-m_microsbefore_websocketsendcalled);
  }

  if (Sweep_Mode == NPV)
  {
    // void runNPV(uint8_t lmpGain, int16_t startV, int16_t endV,
    //         int8_t pulseAmp, uint32_t pulse_width, uint32_t pulse_period,
    //         uint32_t quietTime, uint8_t range, bool setToZero)
    LMPgainGLOBAL = sweep_param_lmpGain;
    runNPV(sweep_param_lmpGain, sweep_param_startV_NPV, sweep_param_endV_NPV,
           sweep_param_pulseAmp_NPV, sweep_param_width_NPV, sweep_param_period_NPV,
           sweep_param_quietTime_NPV, 1, sweep_param_setToZero);
    writeVoltsCurrentArraytoFile();
    // sendVoltammogramWebsocketJSON();
    sendVoltammogramWebsocketBIN();
    Sweep_Mode = dormant;
    send_is_sweeping_status_over_websocket(false);
  }

  else if (Sweep_Mode == DPV)
  {
    LMPgainGLOBAL = sweep_param_lmpGain;
    runDPV(sweep_param_lmpGain, sweep_param_startV_DPV, sweep_param_endV_DPV,
           sweep_param_pulseAmp_DPV, sweep_param_pulseStep_DPV,sweep_param_width_DPV, sweep_param_period_DPV,
           sweep_param_quietTime_DPV, 1, sweep_param_setToZero);
    writeVoltsCurrentArraytoFile();
    // sendVoltammogramWebsocketJSON();
    sendVoltammogramWebsocketBIN();
    Sweep_Mode = dormant;
    send_is_sweeping_status_over_websocket(false);
  }


  else if (Sweep_Mode == CV)
  {
    LMPgainGLOBAL = sweep_param_lmpGain;
    runCV(sweep_param_lmpGain, sweep_param_cycles_CV, sweep_param_startV_CV,
          sweep_param_endV_CV, sweep_param_vertex1_CV, sweep_param_vertex2_CV, sweep_param_stepV_CV,
          sweep_param_rate_CV, sweep_param_setToZero);
    writeVoltsCurrentArraytoFile();
    // sendVoltammogramWebsocketJSON();
    sendVoltammogramWebsocketBIN();
    Sweep_Mode = dormant;
    send_is_sweeping_status_over_websocket(false);
  }
  else if (Sweep_Mode == SQV)
  {
    LMPgainGLOBAL = sweep_param_lmpGain;

    runSWV(sweep_param_lmpGain, sweep_param_startV_SWV, sweep_param_endV_SWV,
           sweep_param_pulseAmp_SWV, sweep_param_stepV_SWV, sweep_param_freq_SWV, sweep_param_setToZero);
    writeVoltsCurrentArraytoFile();
    // sendVoltammogramWebsocketJSON();
    sendVoltammogramWebsocketBIN();
    Sweep_Mode = dormant;
    send_is_sweeping_status_over_websocket(false);
  }
  else if (Sweep_Mode == CA)
  {
    LMPgainGLOBAL = sweep_param_lmpGain;
    runAmp(sweep_param_lmpGain, sweep_param_pre_stepV_CA, sweep_param_quietTime_CA,
           sweep_param_V1_CA, sweep_param_t1_CA, sweep_param_V2_CA, sweep_param_t2_CA,
           sweep_param_samples_CA, 1, sweep_param_setToZero);
    writeVoltsCurrentArraytoFile();
    // sendVoltammogramWebsocketJSON();
    sendVoltammogramWebsocketBIN();
    Sweep_Mode = dormant;
    send_is_sweeping_status_over_websocket(false);
  }
  else if (Sweep_Mode == DCBIAS)
  {
    LMPgainGLOBAL = sweep_param_lmpGain;

    testNoiseAtABiasPoint(sweep_param_biasV_noisetest, sweep_param_numPoints_noisetest,
                          sweep_param_delayTime_ms_noisetest);
    writeVoltsCurrentArraytoFile();
    // sendVoltammogramWebsocketJSON();
    sendVoltammogramWebsocketBIN();
    Sweep_Mode = dormant;
    send_is_sweeping_status_over_websocket(false);
  }
  else if (Sweep_Mode == IV)
  {
    LMPgainGLOBAL = sweep_param_lmpGain;

    testIV(sweep_param_startV_IV, sweep_param_endV_IV, sweep_param_numPoints_IV,
           sweep_param_delayTime_ms_IV);
    writeVoltsCurrentArraytoFile();
    //sendVoltammogramWebsocketJSON();
    sendVoltammogramWebsocketBIN();
    Sweep_Mode = dormant;
    send_is_sweeping_status_over_websocket(false);
  }
  else if (Sweep_Mode == CAL)
  {
    LMPgainGLOBAL = sweep_param_lmpGain;

    calibrateDACandADCs(sweep_param_delayTime_ms_CAL);
    Sweep_Mode = dormant;
    send_is_sweeping_status_over_websocket(false);
    writeCalFile();
  }
  else if (Sweep_Mode == CTLPANEL)
  {

    pStat.setGain(LMPgainGLOBAL);

    delay(sweep_param_delayTime_ms_control_panel);
    // read adc and convert to current:
    analog_read_avg_bits_temp = (float)analog_read_avg(num_adc_readings_to_average_control_panel, LMP);
    v1_temp = (3.3 / 255.0) * (1 / (2.0 * b_coeff)) * analog_read_avg_bits_temp - (a_coeff / (2.0 * b_coeff)) * (3.3 / 255.0); // LMP is wired to Vout of the LMP91000
    v1_temp = v1_temp * 1000.0;
    v2_temp = dacVout * .5;                                                                //the zero of the internal transimpedance amplifier
    amps_temp = (((v1_temp - v2_temp) / 1000) / TIA_GAIN[LMPgainGLOBAL - 1]) * pow(10, 6); //scales to uA
    // create json string to send to broswer:
    temp_json_string = "{\"amps\":";
    temp_json_string += String(amps_temp, DEC);
    temp_json_string += ",\"volts\":";
    temp_json_string += String(cell_voltage_control_panel);
    temp_json_string += ",\"time\":";
    temp_json_string += String(millis());
    temp_json_string += ",\"analog_read_avg_bits\":";
    temp_json_string += String(analog_read_avg_bits_temp);
    temp_json_string += ",\"analog_read_avg_mV\":";
    temp_json_string += String(v1_temp, DEC);
    temp_json_string += "}";
    // send json string to browswer
    m_websocketserver.broadcastTXT(temp_json_string.c_str(), temp_json_string.length());
  }
  else if (Sweep_Mode == MISC_MODE) // list directory to serial
  {
    listDir("/", 3);
    //    delay(250);
    // sendVoltammogramWebsocketJSON();
    // readFileAndPrintToSerial();
    Sweep_Mode = dormant;
    send_is_sweeping_status_over_websocket(false);

    sendVoltammogramWebsocketBIN();
  }
  else
  {
    delay(10);
  }
  last_time_loop_called = millis();
}

/* =================================================================
 *  新增模块：从机（流体控制板）通信 + 实验调度
 * ================================================================= */

/* ---------------- 从机链路（Wi-Fi / TCP） ---------------- */
String   g_slaveRxBuf      = "";
uint32_t g_slaveLastMsgMs  = 0;
uint32_t g_slaveLastPingMs = 0;
uint32_t g_slaveConnectMs  = 0;
bool     g_slaveOnline     = false;
bool     g_slavePumpOn     = false;
bool     g_slaveValve0     = false;
bool     g_slaveValve1     = false;
bool     g_slaveReportedFault = false;   // 从机主动上报了 fault
String   g_slaveFaultCode     = "";

// 发一行 JSON 给从机；未连接时直接丢弃，绝不阻塞
void slaveSend(const String& json)
{
  if (g_slaveClient && g_slaveClient.connected())
  {
    g_slaveClient.println(json);
    Serial.print("[TO SLAVE] ");
    Serial.println(json);
  }
  else
  {
    Serial.print("[SLAVE OFFLINE] ");
    Serial.println(json);
  }
}

// 收从机发来的响应 / 事件（TCP Server 轮询 + 按行解析）
void slaveLoop()
{
  // ① 接受新连接：同一时刻只保留一个从机
  WiFiClient m_newClient = g_slaveServer.available();
  if (m_newClient)
  {
    if (g_slaveClient && g_slaveClient.connected())
    {
      Serial.println("[SLAVE] extra client rejected");
      m_newClient.stop();
    }
    else
    {
      g_slaveClient = m_newClient;
      g_slaveClient.setNoDelay(true);
      g_slaveRxBuf = "";
      g_slaveRxBuf.reserve(512);
      g_slaveConnectMs = millis();
      Serial.print("[SLAVE] client connected from ");
      Serial.println(g_slaveClient.remoteIP());
    }
  }

  // ② 按行读取：\r 忽略，\n 触发解析，单行上限 512 B
  while (g_slaveClient && g_slaveClient.connected() && g_slaveClient.available() > 0)
  {
    char c = (char)g_slaveClient.read();
    if (c == '\r') continue;
    if (c != '\n')
    {
      if (g_slaveRxBuf.length() < 512) g_slaveRxBuf += c;
      continue;
    }

    String m_line = g_slaveRxBuf;
    g_slaveRxBuf = "";
    if (m_line.length() == 0) continue;

    StaticJsonDocument<512> m_slaveDoc;
    if (deserializeJson(m_slaveDoc, m_line) != DeserializationError::Ok)
    {
      Serial.println("[SLAVE] bad json, dropped");
      continue;
    }

    String m_evt = m_slaveDoc["evt"] | "";

    // 握手：校验 key，hello 行绝不转发给网页
    if (m_evt == "hello")
    {
      String m_key = m_slaveDoc["key"] | "";
      if (m_key != SLAVE_LINK_KEY)
      {
        Serial.println("[SLAVE] hello rejected");
        g_slaveOnline = false;
        g_slaveClient.stop();
        g_slaveRxBuf = "";
        expBroadcastState();
        break;
      }
      g_slaveOnline     = true;
      g_slaveLastMsgMs  = millis();
      g_slaveLastPingMs = millis();
      Serial.print("[SLAVE] hello ok fw=");
      Serial.println((const char*)(m_slaveDoc["fw"] | "?"));
      slaveSend("{\"id\":0,\"cmd\":\"status\"}");
      expBroadcastState();
      continue;
    }

    // 未通过 hello 的消息一律不认、不转发
    if (!g_slaveOnline) continue;

    g_slaveLastMsgMs = millis();
    Serial.print("[FROM SLAVE] ");
    Serial.println(m_line);

    // 解析从机状态，供网页显示泵/阀实时状态
    if (m_slaveDoc.containsKey("pump0"))
      g_slavePumpOn = m_slaveDoc["pump0"]["on"] | false;
    if (m_slaveDoc.containsKey("valves"))
    {
      JsonArray m_vs = m_slaveDoc["valves"].as<JsonArray>();
      int m_i = 0;
      for (JsonObject m_v : m_vs)
      {
        if (m_i == 0) g_slaveValve0 = m_v["open"] | false;
        if (m_i == 1) g_slaveValve1 = m_v["open"] | false;
        m_i++;
      }
    }

    // 从机主动上报故障：等实验调度下一圈统一处理
    if (m_evt == "fault")
    {
      g_slaveReportedFault = true;
      g_slaveFaultCode = (const char*)(m_slaveDoc["code"] | "E_SLAVE");
    }

    // 转发给网页，方便在浏览器里看到从机状态
    m_websocketserver.broadcastTXT(m_line.c_str(), m_line.length());
  }

  // ③ 连接后迟迟不 hello：10 s 后断开，避免占住唯一连接位
  if (!g_slaveOnline && g_slaveClient && g_slaveClient.connected() &&
      (millis() - g_slaveConnectMs > 10000UL))
  {
    Serial.println("[SLAVE] handshake timeout");
    g_slaveClient.stop();
    g_slaveRxBuf = "";
  }

  // ④ 心跳：5 s 一次，IDLE 也发（从机无心跳会自动停泵）
  if (g_slaveOnline && (millis() - g_slaveLastPingMs >= 5000UL))
  {
    g_slaveLastPingMs = millis();
    slaveSend("{\"cmd\":\"ping\"}");
  }

  // ⑤ 离线判定：先读完数据再判，避免主机静测阻塞后误判
  if (g_slaveOnline && (!g_slaveClient.connected() ||
                        (millis() - g_slaveLastMsgMs > 20000UL)))
  {
    g_slaveOnline = false;
    g_slaveClient.stop();
    g_slaveRxBuf = "";
    Serial.println("[SLAVE] link lost");
    expBroadcastState();
  }
}

/* ---------------- 实验调度状态机 ---------------- */
enum ExpState { EXP_IDLE, EXP_CIRCULATE, EXP_STOP_FLOW, EXP_MEASURE, EXP_CALIBRATE };

ExpState      g_expState       = EXP_IDLE;
uint32_t      g_expStateStart  = 0;
uint32_t      g_expCycleIdx    = 0;
uint32_t      g_expLastCalibMs = 0;
uint32_t      g_expLastPingMs  = 0;
uint32_t      g_expLastStatusMs = 0;
uint32_t      g_expLastBcastMs  = 0;
uint32_t      g_expStartMs      = 0;   // 本次实验启动时刻
unsigned long g_expCmdId       = 200;

bool     g_expFault     = false;   // 实验故障（从机掉线 / 从机报错）
String   g_expFaultCode = "";
uint32_t g_expSessionStartMs = 0;  // 本次实验数据记录的起点

// 最近一次静测结果
float g_lastCurrentUA = 0.0f;
float g_lastConc      = 0.0f;
bool  g_lastConcValid = false;

// 可调参数（默认值，后续可从网页下发）
uint32_t exp_param_circulate_ms      = 300000UL;    // 循环均质  5 min
uint32_t exp_param_stopflow_ms       = 300000UL;    // 停流平衡  5 min
uint32_t exp_param_calib_interval_ms = 21600000UL;  // 校准周期  6 h
uint32_t exp_param_calib_ms          = 180000UL;    // 单次校准  3 min
uint32_t exp_param_valve_open_ms     = 10000UL;     // 校准阶段阀门开启/排废 10 s（≤30 s）

uint32_t exp_param_pump_pct          = 50UL;        // 泵 PWM 占空比（%，25 号口）

bool    g_expManual    = false;  // 手动接管：为 true 时自动流程已退出
uint8_t g_expCalibPhase = 0;     // 校准子阶段：0=开阀冲洗/排废 1=关阀静置
bool    g_expMeasuring = false;  // 静测采集中（阻塞期间网页显示「进行中」）

const char* expStateName(ExpState s)
{
  switch (s)
  {
    case EXP_IDLE:      return "IDLE";
    case EXP_CIRCULATE: return "CIRCULATE";
    case EXP_STOP_FLOW: return "STOP_FLOW";
    case EXP_MEASURE:   return "MEASURE";
    default:            return "CALIBRATE";
  }
}

/* ---------------- 浓度标定（临时骨架） ---------------- */
void loadConcCalib()
{
  File f = SPIFFS.open("/cell_calib.json", "r");
  if (!f)
  {
    Serial.println("[CAL] 未找到 /cell_calib.json，浓度换算未启用");
    return;
  }
  StaticJsonDocument<256> d;
  DeserializationError err = deserializeJson(d, f);
  f.close();
  if (err)
  {
    Serial.println("[CAL] cell_calib.json 解析失败");
    return;
  }
  g_concSlope     = d["slope"] | 0.0f;
  g_concIntercept = d["intercept"] | 0.0f;
  Serial.printf("[CAL] slope=%.4f uA/mM, intercept=%.4f uA\n", g_concSlope, g_concIntercept);
}

void saveConcCalib()
{
  File f = SPIFFS.open("/cell_calib.json", "w");
  if (!f)
  {
    Serial.println("[CAL] 无法写入 cell_calib.json");
    return;
  }
  String s = "{\"slope\":";
  s += String(g_concSlope, 4);
  s += ",\"intercept\":";
  s += String(g_concIntercept, 4);
  s += "}";
  f.print(s);
  f.close();
  Serial.print("[CAL] 已保存 ");
  Serial.println(s);
}

/* ---------------- 实验数据存档（多源统一时间戳） ---------------- */
// 统一表结构：每条记录同时带 boot 相对时间与 epoch 绝对时间，
// source 区分来源，便于后续异构数据按时间对齐（FR-9）。
//   source：electrochem（电化学）| cell_activity（细胞活性，预留）| fluid（泵阀）| system
#define LOG_FILE   "/experiment.csv"
#define LOG_BACKUP "/experiment_prev.csv"
#define LOG_HEADER "seq,source,type,cycle,t_boot_ms,t_epoch_ms,session_ms,current_uA,conc_mM,slope_uA_per_mM,intercept_uA,value,unit,note"

uint32_t g_logSeq = 0;

/* ---------------- 统一时钟 ---------------- */
uint64_t g_bootEpochMs     = 0;   // 0 = 尚未对时
bool     g_timeSyncStarted = false;
uint32_t g_lastTimeChkMs   = 0;

// 通用写行：hasCurrent / concValid 控制电化学字段是否留空；
// unit 非空时才写 value，其他来源（如细胞活性）用它。
void expLogRow(const char *source, const char *type, uint32_t cycle,
               bool hasCurrent, float currentUA,
               bool concValid, float conc,
               double value, const char *unit, const char *note)
{
  File f = SPIFFS.open(LOG_FILE, "a");
  if (!f)
  {
    Serial.println("[LOG] 追加失败：" LOG_FILE);
    return;
  }

  uint64_t epochMs = nowEpochMs();

  f.print(++g_logSeq);            f.print(',');
  f.print(source ? source : "");  f.print(',');
  f.print(type ? type : "");      f.print(',');
  f.print(cycle);                 f.print(',');
  f.print(millis());              f.print(',');
  if (epochMs) f.print((unsigned long long)epochMs);
  f.print(',');
  f.print(millis() - g_expSessionStartMs); f.print(',');
  if (hasCurrent) f.print(currentUA, 4);
  f.print(',');
  if (concValid) f.print(conc, 4);
  f.print(',');
  f.print(g_concSlope, 4);        f.print(',');
  f.print(g_concIntercept, 4);    f.print(',');
  if (unit && unit[0]) f.print(value, 4);
  f.print(',');
  f.print(unit ? unit : "");      f.print(',');
  f.println(note ? note : "");
  f.close();
}

void expLogAppend(uint32_t cycle, const char *type, float currentUA, float conc,
                  bool concValid, const char *note)
{
  expLogRow("electrochem", type, cycle, true, currentUA, concValid, conc, 0.0, "", note);
}

// 其他来源（细胞活性等）的数据注入接口
void expLogExt(const char *source, const char *type, double value,
               const char *unit, const char *note)
{
  expLogRow(source, type, g_expCycleIdx, false, 0.0f, false, 0.0f, value, unit, note);
  Serial.printf("[LOG] ext %s/%s = %.4f %s\n", source, type, value, unit ? unit : "");
}

// 记录 boot→epoch 映射：对时之前写入的行没有 epoch，可据此回推
void expLogTimeSync()
{
  double epochSec = (double)(g_bootEpochMs / 1000ULL);
  expLogRow("system", "TIME_SYNC", g_expCycleIdx, false, 0.0f, false, 0.0f,
            epochSec, "epoch_s", "boot->epoch mapping");
}

void expLogBeginSession()
{
  // 表结构变了就把旧存档转存，避免新旧列错位
  bool needNewFile = true;
  File r = SPIFFS.open(LOG_FILE, "r");
  if (r)
  {
    String first = r.readStringUntil('\n');
    first.trim();
    needNewFile = (first != LOG_HEADER);
    r.close();
  }

  if (needNewFile && SPIFFS.exists(LOG_FILE))
  {
    if (SPIFFS.exists(LOG_BACKUP)) SPIFFS.remove(LOG_BACKUP);
    SPIFFS.rename(LOG_FILE, LOG_BACKUP);
    Serial.println("[LOG] 旧格式存档已转存 " LOG_BACKUP);
  }

  File w = SPIFFS.open(LOG_FILE, "a");
  if (!w)
  {
    Serial.println("[LOG] 无法打开 " LOG_FILE);
    return;
  }
  if (w.size() == 0) w.println(LOG_HEADER);
  w.close();

  g_logSeq = 0;
  expLogRow("system", "SESSION_START", 0, false, 0.0f, false, 0.0f, 0.0, "", "");
}

/* ---------------- 统一时钟 ---------------- */
uint64_t nowEpochMs()
{
  if (g_bootEpochMs == 0) return 0;
  return g_bootEpochMs + (uint64_t)millis();
}

// 非阻塞对时：STA 连上路由器后启一次 NTP；之后每 10 s 检查一次
void timeSyncTick()
{
  if (millis() - g_lastTimeChkMs < 10000UL) return;
  g_lastTimeChkMs = millis();

  time_t nowSec = time(nullptr);
  if (nowSec > 1700000000)   // 已拿到有效时间
  {
    if (g_bootEpochMs == 0)
    {
      g_bootEpochMs = (uint64_t)nowSec * 1000ULL - (uint64_t)millis();
      Serial.print("[TIME] epoch ok: ");
      Serial.println((unsigned long)nowSec);
      expLogTimeSync();
      expBroadcastState();
    }
    return;
  }

  if (!g_timeSyncStarted && WiFi.status() == WL_CONNECTED)
  {
    configTime(0, 0, "ntp.aliyun.com", "pool.ntp.org");
    g_timeSyncStarted = true;
    Serial.println("[TIME] NTP sync started");
  }
}

/* ---------------- 静测电流取稳定段 ---------------- */
float expStableCurrent()
{
  int s = g_ampPhaseStart[1];   // 阶段 1 = 第一段保持电位 v1
  int e = g_ampPhaseEnd[1];
  if (e <= s || e > number_of_valid_points_in_volts_amps_array)
  {
    s = 0;
    e = number_of_valid_points_in_volts_amps_array;
  }
  int n = e - s;
  if (n <= 0) return 0.0f;

  int start = s + (n * 7) / 10;   // 取该阶段后 30% 作为稳定段
  if (start >= e) start = s;

  double sum = 0;
  int cnt = 0;
  for (int i = start; i < e; i++)
  {
    sum += amps[i];
    cnt++;
  }
  return cnt ? (float)(sum / cnt) : 0.0f;
}

/* ---------------- 算法校准（漂移补偿）+ 自适应调度 ---------------- */
// 校准历史：记录每次硬件校准的 (时间, 斜率, 截距)。
// 漂移补偿用历史趋势外推当前系数；自适应调度用漂移速率调整校准间隔。
#define CALIB_HISTORY_MAX 16
struct CalibPoint {
  uint32_t t_ms;      // 相对实验启动 (ms)
  float    slope;     // µA/mM
  float    intercept; // µA
};
CalibPoint g_calibHistory[CALIB_HISTORY_MAX];
int        g_calibCount = 0;

// 根据漂移速率动态调整校准间隔（漂移快 -> 加密，慢 -> 放宽）
void expAdaptCalibInterval()
{
  if (g_calibCount < 2)
  {
    exp_param_calib_interval_ms = 21600000UL;   // 默认 6 h
    return;
  }
  CalibPoint &p1 = g_calibHistory[g_calibCount - 2];
  CalibPoint &p2 = g_calibHistory[g_calibCount - 1];
  float dt_h = (float)(p2.t_ms - p1.t_ms) / 3600000.0f;
  if (dt_h <= 0.0f) return;

  float drift_rate = fabs(p2.slope - p1.slope) / dt_h;  // µA/mM per hour

  // 阈值是初值，需用 V1 标准液数据标定
  if (drift_rate > 0.02f)        exp_param_calib_interval_ms = 10800000UL;  // 3 h
  else if (drift_rate < 0.005f)  exp_param_calib_interval_ms = 32400000UL;  // 9 h
  else                           exp_param_calib_interval_ms = 21600000UL;  // 6 h

  Serial.printf("[CAL] drift=%.4f uA/mM/h -> interval=%lu min\n",
                drift_rate, (unsigned long)(exp_param_calib_interval_ms / 60000UL));
}

// 硬件校准完成后调用：记录校准点 + 更新当前系数 + 触发自适应调度
void expRecordCalibration(float slope, float intercept)
{
  uint32_t t_rel = millis() - g_expSessionStartMs;

  if (g_calibCount < CALIB_HISTORY_MAX)
  {
    g_calibHistory[g_calibCount].t_ms      = t_rel;
    g_calibHistory[g_calibCount].slope     = slope;
    g_calibHistory[g_calibCount].intercept = intercept;
    g_calibCount++;
  }
  else
  {
    // 环形：丢弃最旧，追加最新
    for (int i = 1; i < CALIB_HISTORY_MAX; i++)
      g_calibHistory[i - 1] = g_calibHistory[i];
    g_calibHistory[CALIB_HISTORY_MAX - 1].t_ms      = t_rel;
    g_calibHistory[CALIB_HISTORY_MAX - 1].slope     = slope;
    g_calibHistory[CALIB_HISTORY_MAX - 1].intercept = intercept;
  }

  g_concSlope     = slope;
  g_concIntercept = intercept;
  expAdaptCalibInterval();

  // 校准记录落盘，便于追溯（slope/intercept 已由 expLogAppend 一并写入）
  expLogAppend(g_expCycleIdx, "CALIB", 0.0f, 0.0f, false, "hardware calibration");
}

// 漂移补偿：用最近两次校准的斜率趋势，线性外推当前时刻的系数
void expCompensatedCalib(uint32_t t_rel, float &slope, float &intercept)
{
  if (g_calibCount == 0)
  {
    slope     = g_concSlope;
    intercept = g_concIntercept;
    return;
  }
  if (g_calibCount == 1)
  {
    slope     = g_calibHistory[0].slope;
    intercept = g_calibHistory[0].intercept;
    return;
  }

  CalibPoint &p1 = g_calibHistory[g_calibCount - 2];
  CalibPoint &p2 = g_calibHistory[g_calibCount - 1];
  float dt      = (float)(p2.t_ms - p1.t_ms);
  float dt_now  = (float)(t_rel - p2.t_ms);

  if (dt > 0.0f)
  {
    float k_s = (p2.slope - p1.slope) / dt;
    float k_i = (p2.intercept - p1.intercept) / dt;
    slope     = p2.slope     + k_s * dt_now;
    intercept = p2.intercept + k_i * dt_now;
  }
  else
  {
    slope     = p2.slope;
    intercept = p2.intercept;
  }
}

void expUpdateConcentration(float currentUA)
{
  g_lastCurrentUA = currentUA;

  float slope, intercept;
  if (g_calibCount >= 2)
    expCompensatedCalib(millis() - g_expSessionStartMs, slope, intercept);
  else
  {
    slope     = g_concSlope;
    intercept = g_concIntercept;
  }

  if (fabs(slope) > 1e-6)
  {
    g_lastConc      = (currentUA - intercept) / slope;
    g_lastConcValid = true;
  }
  else
  {
    g_lastConc      = 0.0f;
    g_lastConcValid = false;
  }
}

void expBroadcastState()
{
  uint32_t m_calib_in_ms = 0;
  if (g_expState != EXP_IDLE)
  {
    uint32_t m_elapsed = millis() - g_expLastCalibMs;
    m_calib_in_ms = (m_elapsed >= exp_param_calib_interval_ms)
                        ? 0
                        : (exp_param_calib_interval_ms - m_elapsed);
  }

  // 当前阶段的「下一动作」与剩余时间（网页据此倒计时）
  const char* m_next    = "none";
  uint32_t    m_next_in = 0;
  uint32_t    m_elapsed = millis() - g_expStateStart;
  uint32_t    m_total   = 0;
  switch (g_expState)
  {
    case EXP_CIRCULATE:
      m_next = "pump_stop";  m_total = exp_param_circulate_ms; break;
    case EXP_STOP_FLOW:
      // 停流 = 泵停 + 阀关，保持闭环密闭静置
      m_next = "measure";  m_total = exp_param_stopflow_ms; break;
    case EXP_MEASURE:
      if (g_expMeasuring) { m_next = "measuring"; }
      else                { m_next = "measure"; m_total = 2000UL; }
      break;
    case EXP_CALIBRATE:
      // 校准：先开阀冲洗/排废，再关阀静置
      if (g_expCalibPhase == 0) { m_next = "calib_flush"; m_total = exp_param_valve_open_ms; }
      else                      { m_next = "calib_wait";  m_total = exp_param_calib_ms; }
      break;
    default:
      break;
  }
  if (m_total > 0) m_next_in = (m_elapsed < m_total) ? (m_total - m_elapsed) : 0;

  String s = "{\"exp_state\":\"";
  s += expStateName(g_expState);
  s += "\",\"mode\":\"";
  s += (g_expState != EXP_IDLE) ? "auto" : (g_expManual ? "manual" : "idle");
  s += "\",\"exp_cycle\":";
  s += String(g_expCycleIdx);
  s += ",\"calib_in_ms\":";
  s += String(m_calib_in_ms);
  s += ",\"next_action\":\"";
  s += m_next;
  s += "\",\"next_in_ms\":";
  s += String(m_next_in);
  s += ",\"pump_on\":";
  s += (g_slavePumpOn ? "true" : "false");
  s += ",\"valve0\":";
  s += (g_slaveValve0 ? "true" : "false");
  s += ",\"valve1\":";
  s += (g_slaveValve1 ? "true" : "false");
  s += ",\"circulate_min\":";
  s += String(exp_param_circulate_ms / 60000UL);
  s += ",\"stopflow_min\":";
  s += String(exp_param_stopflow_ms / 60000UL);
  s += ",\"valve_open_s\":";
  s += String(exp_param_valve_open_ms / 1000UL);
  s += ",\"pump_pct\":";
  s += String(exp_param_pump_pct);
  s += ",\"calib_interval_h\":";
  s += String(exp_param_calib_interval_ms / 3600000UL);
  s += ",\"calib_min\":";
  s += String(exp_param_calib_ms / 60000UL);
  s += ",\"slave_link\":\"";
  s += (g_slaveOnline ? "online" : "offline");
  s += "\",\"exp_fault\":";
  s += (g_expFault ? "true" : "false");
  s += ",\"exp_fault_code\":\"";
  s += g_expFaultCode;
  s += "\",\"last_current_ua\":";
  s += String(g_lastCurrentUA, 4);
  s += ",\"conc_valid\":";
  s += (g_lastConcValid ? "true" : "false");
  s += ",\"last_conc\":";
  s += String(g_lastConc, 4);
  s += ",\"calib_slope\":";
  s += String(g_concSlope, 4);
  s += ",\"calib_intercept\":";
  s += String(g_concIntercept, 4);
  s += ",\"time_synced\":";
  s += (g_bootEpochMs ? "true" : "false");
  s += "}";
  m_websocketserver.broadcastTXT(s.c_str(), s.length());
  if (g_expState != EXP_IDLE)
  {
    Serial.print("[EXP] ");
    Serial.println(s);
  }
}

// 让循环泵开始工作：单次时长 = 循环均质时长 + 60 s 余量，由调度状态机负责停
void expPumpRun()
{
  uint32_t m_ms = exp_param_circulate_ms + 60000UL;
  slaveSend("{\"id\":" + String(g_expCmdId++) +
            ",\"cmd\":\"pump\",\"ch\":0,\"speed\":" + String(exp_param_pump_pct) +
            ",\"ms\":" + String(m_ms) + "}");
  g_slavePumpOn = true;
}

// 只停泵：从机没有单独的 pump_stop，用 speed=0 + 极短时长等效
void expPumpStop()
{
  slaveSend("{\"id\":" + String(g_expCmdId++) +
            ",\"cmd\":\"pump\",\"ch\":0,\"speed\":0,\"ms\":1}");
}

// 泵正在运行时应用新的占空比：从机只能整条 pump 命令重启，因此按当前阶段剩余时长重发
void expPumpPctApply()
{
  if (!g_slavePumpOn || !g_slaveOnline) return;

  uint32_t m_ms = 3600000UL;  // 手动模式：沿用 1 h 上限
  if (g_expState == EXP_CIRCULATE || g_expState == EXP_CALIBRATE)
  {
    uint32_t m_total = (g_expState == EXP_CIRCULATE) ? exp_param_circulate_ms
                                                     : exp_param_calib_ms;
    uint32_t m_used  = millis() - g_expStateStart;
    uint32_t m_left  = (m_used < m_total) ? (m_total - m_used) : 1000UL;
    m_ms = m_left + 60000UL;
    if (m_ms > 3600000UL) m_ms = 3600000UL;
  }
  slaveSend("{\"id\":" + String(g_expCmdId++) +
            ",\"cmd\":\"pump\",\"ch\":0,\"speed\":" + String(exp_param_pump_pct) +
            ",\"ms\":" + String(m_ms) + "}");
}

// 单路阀门开/关（ch0=切换阀 ch1=排废阀）
void expValveSet(uint8_t ch, bool open)
{
  slaveSend("{\"id\":" + String(g_expCmdId++) + ",\"cmd\":\"valve\",\"ch\":" +
            String(ch) + ",\"state\":\"" + (open ? "open" : "close") + "\"}");
}

// 进入实验故障态：停泵关阀、记录、通知网页
void expFault(const char *code)
{
  Serial.print("[EXP] FAULT: ");
  Serial.println(code);
  slaveSend("{\"id\":" + String(g_expCmdId++) + ",\"cmd\":\"stop_all\"}");
  g_expState     = EXP_IDLE;
  g_expFault     = true;
  g_expFaultCode = code;
  expLogAppend(g_expCycleIdx, "FAULT", g_lastCurrentUA, g_lastConc, g_lastConcValid, code);
  expBroadcastState();
}

// 启动实验
void expStart()
{
  // 从机离线时拒绝启动，避免实验空转
  if (!g_slaveOnline)
  {
    m_websocketserver.broadcastTXT("{\"exp_error\":\"slave_offline\"}");
    Serial.println("[EXP] start rejected: slave offline");
    return;
  }

  uint32_t now     = millis();
  g_expCycleIdx    = 0;
  g_expLastCalibMs = now;
  g_expLastPingMs  = now;
  g_expLastStatusMs = now;
  g_expLastBcastMs  = now;
  g_expStateStart  = now;
  g_expStartMs     = now;
  g_expSessionStartMs = now;
  g_expManual      = false;
  g_expCalibPhase  = 0;
  g_expMeasuring   = false;
  g_expFault       = false;
  g_expFaultCode   = "";
  g_slaveReportedFault = false;
  g_lastCurrentUA  = 0.0f;
  g_lastConc       = 0.0f;
  g_lastConcValid  = false;
  g_expState       = EXP_CIRCULATE;
  // 先归位（手动遗留的阀门/泵全部关闭），再开泵
  slaveSend("{\"id\":" + String(g_expCmdId++) + ",\"cmd\":\"stop_all\"}");
  g_calibCount     = 0;
  expLogBeginSession();
  // 算法校准：初始标定（若有）作为第一个校准点
  if (fabs(g_concSlope) > 1e-6)
    expRecordCalibration(g_concSlope, g_concIntercept);
  expPumpRun();
  g_slavePumpOn = true;
  g_slaveValve0 = false;
  g_slaveValve1 = false;
  Serial.println("=== 实验启动 ===");
  expBroadcastState();
}

// 停止实验
void expStop()
{
  slaveSend("{\"id\":" + String(g_expCmdId++) + ",\"cmd\":\"stop_all\"}");
  g_expState     = EXP_IDLE;
  g_expFault     = false;
  g_expFaultCode = "";
  g_expManual    = false;
  g_expCalibPhase = 0;
  g_expMeasuring = false;
  Sweep_Mode     = dormant;
  g_slavePumpOn  = false;
  g_slaveValve0  = false;
  g_slaveValve1  = false;
  expLogAppend(g_expCycleIdx, "STOP", g_lastCurrentUA, g_lastConc, g_lastConcValid, "user stop");
  Serial.println("=== 实验停止 ===");
  expBroadcastState();
}

// 手动控制（target: 0=泵 1=切换阀 2=排废阀）
// 任何手动动作都先退出自动流程并停泵停阀，之后必须重新点「启动实验」才回到自动
void expManual(uint8_t target, bool on)
{
  if (!g_slaveOnline)
  {
    m_websocketserver.broadcastTXT("{\"exp_error\":\"slave_offline\"}");
    Serial.println("[EXP] manual rejected: slave offline");
    return;
  }

  if (g_expState != EXP_IDLE)
  {
    slaveSend("{\"id\":" + String(g_expCmdId++) + ",\"cmd\":\"stop_all\"}");
    g_expState = EXP_IDLE;
    Sweep_Mode = dormant;
    Serial.println("[EXP] 手动接管，自动流程已退出");
  }

  g_expManual    = true;
  g_expCalibPhase = 0;
  g_expMeasuring = false;

  if (target == 0)
  {
    if (on)
    {
      // 手动开泵：使用网页设定的占空比，单次上限 60 min（与从机 PUMP_MAX_MS 一致）
      slaveSend("{\"id\":" + String(g_expCmdId++) +
                ",\"cmd\":\"pump\",\"ch\":0,\"speed\":" + String(exp_param_pump_pct) +
                ",\"ms\":3600000}");
      g_slavePumpOn = true;
    }
    else
    {
      expPumpStop();
      g_slavePumpOn = false;
    }
  }
  else
  {
    // 手动开阀：从机 30 s 自动关闭（VALVE_MAX_ON_MS）
    expValveSet(target - 1, on);
    if (target == 1) g_slaveValve0 = on;
    else             g_slaveValve1 = on;
  }

  expBroadcastState();
}

// 静测：调用 NanoStat 现有的计时安培法采一个点（阻塞，跑完返回）
void expRunMeasure()
{
  Serial.println("[EXP] 静测中 ...");
  LMPgainGLOBAL = sweep_param_lmpGain;
  runAmp(sweep_param_lmpGain, sweep_param_pre_stepV_CA, sweep_param_quietTime_CA,
         sweep_param_V1_CA, sweep_param_t1_CA, sweep_param_V2_CA, sweep_param_t2_CA,
         sweep_param_samples_CA, 1, sweep_param_setToZero);
  writeVoltsCurrentArraytoFile();
  sendVoltammogramWebsocketBIN();
  Serial.println("[EXP] 静测完成");
}

// 调度主函数，每圈 loop 调一次
void serviceExperiment()
{
  uint32_t now = millis();

  if (g_expState == EXP_IDLE)
  {
    // 空闲时从机可能因 120 s 心跳超时上报 fault，不算实验故障
    g_slaveReportedFault = false;
  }
  else
  {
    // 从机主动上报故障
    if (g_slaveReportedFault)
    {
      g_slaveReportedFault = false;
      expFault(g_slaveFaultCode.c_str());
      return;
    }

    // 实验中链路断开：启动 5 s 后开始判定，避免刚启动的瞬时误判
    if (!g_slaveOnline && (now - g_expStartMs > 5000UL))
    {
      expFault("E_SLAVE_OFFLINE");
      return;
    }
  }

  // 每 5 秒查询一次从机状态（泵/阀实际状态）—— IDLE 也查，手动模式同样能刷新
  if (g_slaveOnline && now - g_expLastStatusMs >= 5000UL)
  {
    g_expLastStatusMs = now;
    slaveSend("{\"id\":" + String(g_expCmdId++) + ",\"cmd\":\"status\"}");
  }

  // 自动状态每秒刷新（倒计时），空闲/手动 5 秒刷新一次
  uint32_t m_bcast_ms = (g_expState == EXP_IDLE) ? 5000UL : 1000UL;
  if (now - g_expLastBcastMs >= m_bcast_ms)
  {
    g_expLastBcastMs = now;
    expBroadcastState();
  }

  if (g_expState == EXP_IDLE) return;

  switch (g_expState)
  {
    // ---- ① 循环均质 ----
    case EXP_CIRCULATE:
      if (now - g_expStateStart >= exp_param_circulate_ms)
      {
        slaveSend("{\"id\":" + String(g_expCmdId++) + ",\"cmd\":\"stop_all\"}");
        // 停流：泵停 + 阀关，闭环密闭静置（不在停流阶段开阀）
        g_slavePumpOn   = false;
        g_slaveValve0   = false;
        g_slaveValve1   = false;
        g_expState      = EXP_STOP_FLOW;
        g_expStateStart = now;
        expBroadcastState();
      }
      break;

    // ---- ② 停流平衡（泵停 + 阀全关，闭环密闭）----
    case EXP_STOP_FLOW:
      if (now - g_expStateStart >= exp_param_stopflow_ms)
      {
        g_expState      = EXP_MEASURE;
        g_expStateStart = now;
        expBroadcastState();
      }
      break;

    // ---- ③ 静测读数 ----
    case EXP_MEASURE:
      if (now - g_expStateStart >= 2000)   // 进入后等 2 秒再测
      {
        g_expMeasuring = true;
        expBroadcastState();      // 先让网页显示「静测采集中」
        expRunMeasure();          // 阻塞：跑完一次安培法
        g_expMeasuring = false;

        float m_current = expStableCurrent();
        expUpdateConcentration(m_current);
        g_expCycleIdx++;
        g_expCalibPhase = 0;
        expLogAppend(g_expCycleIdx, "MEASURE", m_current, g_lastConc, g_lastConcValid, "");
        Serial.printf("[EXP] cycle=%u  I=%.4f uA  C=%.4f mM (valid=%d)\n",
                      g_expCycleIdx, m_current, g_lastConc, g_lastConcValid);

        if (millis() - g_expLastCalibMs >= exp_param_calib_interval_ms)
        {
          g_expState      = EXP_CALIBRATE;
          g_expCalibPhase = 0;
          // 校准支路（原停流阶段的开阀逻辑移到这里）：
          // 开切换阀 V1（标准液侧）+ 排废阀 V2（废液侧），先靠重力/静压置换
          expValveSet(0, true);
          expValveSet(1, true);
          g_slaveValve0 = true;
          g_slaveValve1 = true;
          expLogAppend(g_expCycleIdx, "CALIBRATE_START", 0, 0, false,
                       "valve0+valve1 open");
        }
        else
        {
          g_expState = EXP_CIRCULATE;
          expPumpRun();
        }
        g_expStateStart = millis();
        expBroadcastState();
      }
      break;

    // ---- ④ 在线校准（子阶段 0：开阀冲洗/排废；子阶段 1：关阀静置）----
    case EXP_CALIBRATE:
    {
      uint32_t m_flush = exp_param_valve_open_ms;
      if (m_flush > exp_param_calib_ms) m_flush = exp_param_calib_ms;

      if (g_expCalibPhase == 0 && now - g_expStateStart >= m_flush)
      {
        slaveSend("{\"id\":" + String(g_expCmdId++) + ",\"cmd\":\"stop_all\"}");
        g_slaveValve0  = false;
        g_slaveValve1  = false;
        g_expCalibPhase = 1;
        expBroadcastState();
        break;
      }

      if (now - g_expStateStart >= exp_param_calib_ms)
      {
        g_expLastCalibMs = millis();
        // TODO 硬件校准：在子阶段 0 内需开泵抽标准液经电极流到 V2 排废，
        //      并在关阀静置后静测标准液读数，得到新斜率/截距，再调用
        //      expRecordCalibration(newSlope, newIntercept)。
        //      前提：回流支路需夹断（或加第 3 个阀），否则标准液可能进下腔。
        expLogAppend(g_expCycleIdx, "CALIBRATE_PLACEHOLDER", 0, 0, false,
                     "standard-liquid branch not implemented");
        g_expState       = EXP_CIRCULATE;
        g_expCalibPhase  = 0;
        g_expStateStart  = millis();
        expPumpRun();
        expBroadcastState();
      }
      break;
    }
  }
}
