LiangPI-boob/cell-metabolism-monitor/(commit log)

2026-10-18 初始提交：主机固件 + 网页 + 从机固件 + 设计文档
    [BOM_1-PCB_ESP32StatRev3_5PCB_2022-08-24.csv, BOM_1-PCB_ESP32StatRev3_5_1PCB_2022-08-24.csv, BOM_ESP32StatRev3_5_4_2024-11-27.csv, Case.stl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]
2026-10-18 同步项目进度：主机烧录、AP 模式、UART2 改 32/33、Gitee 仓库
2026-10-25 重构仓库结构：硬件资料归档至 hardware/、网页资源拆分至 data/assets、新增从机固件与设计文档
    [BOM_1-PCB_ESP32StatRev3_5PCB_2022-08-24.csv, BOM_1-PCB_ESP32StatRev3_5_1PCB_2022-08-24.csv, BOM_ESP32StatRev3_5_4_2024-11-27.csv, Case.stl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]
2026-10-25 同步文档：更新主从 WiFi 通信开发文档与项目进度总结
2026-10-25 新增协作者同步摘要，标注 Gitee 为协作者旧地址并补充 GitHub 仓库地址
2026-10-25 移植实验数据存档、掉线停机、浓度换算与演示模式到 Wi-Fi 架构
    1) 每次静测追加写入 experiment.csv，并提供 /download_exp 下载；2) 实验中链路断开或从机上报故障时自动停机并记录；3) 静测取稳定段平均电流，支持 cell_calib.json 标定换算浓度；4) 网页新增最近电流/浓度、标定输入、故障提示和实验 CSV 下载；5) 新增 index.html?demo=1 本地演示模式；6) 新增 72 小时实验数据离线分析脚本；7) 修复 uPlot points.show 类型错误。
    [main.cpp]
2026-10-27 网页与主机固件增强：实时状态监控与泵 PWM 可调
    - 状态广播新增 mode/next_action/next_in_ms/pump_pct；停流拆为「开阀 valve_open_s + 关阀静置」两段
    - 新增手动泵阀控制（先 stop_all 并退出自动流程）与阀门时长、泵 PWM 参数，支持运行中即时生效
    - 网页新增下一动作倒计时、泵阀离线态、6 个手动按钮与 PWM 滑块
2026-10-27 文档：记录 2026-10-27 改动（第 4 轮实时状态监控 + 泵 PWM）并同步协作者摘要
2026-10-27 文档：补充合并远端后的编译数据与冲突处理说明
2026-10-27 文档：补充版本标记约定，标注 v0.4.0 基线
2026-10-27 算法校准与多源同步落地；停流恢复密闭，开阀逻辑移入校准阶段
    1) 合并 v0.4.0：实时状态监控、泵 PWM 可调、手动泵阀控制；2) 新增软硬联合校准：校准历史记录、漂移线性外推补偿、按漂移速率自适应校准间隔；3) 新增多源数据同步：experiment.csv 统一表结构（seq/source/t_epoch_ms/value/unit）、NTP 对时、TIME_SYNC 映射、WebSocket 外部数据注入、网页时间同步显示；4) 按方案 A 调整流程：STOP_FLOW 恢复为泵停+阀全关，开阀逻辑移入 CALIBRATE（先双阀冲洗/排废，再关阀静置）；5) 分析脚本兼容新旧表结构；6) 新增 tools/calibration_sim.py 离线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
